Ishfaq-code/magneto/exports/servo-reset/electronics-preview.png

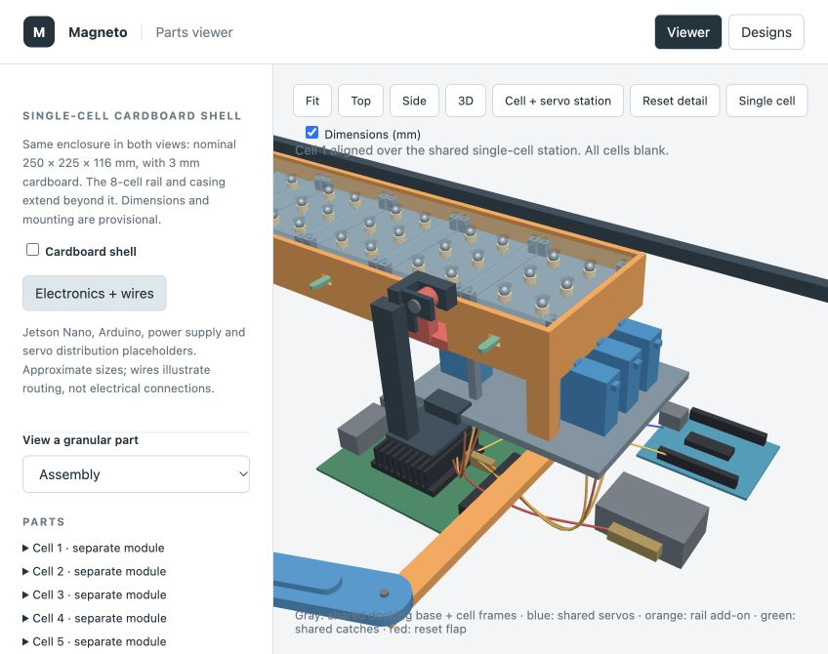
exports/servo-reset/electronics-preview.png
