Ishfaq-code/magneto/story-fullscreen.png

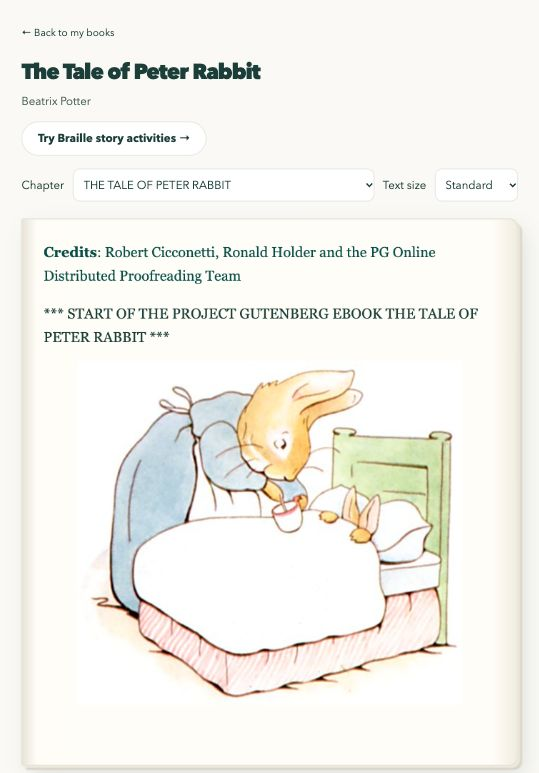
story-fullscreen.png
