Ishfaq-code/magneto/.lavish/databricks-architecture.html

MAGNETO / HACKATHON BUILD MAP

# One mistake changes the next teaching moment.

Proposed architecture: Databricks directs the learning experience. The local runtime preserves the story and controls physical interaction.

## The adaptive loop

MLflow traces every director turn: context, tool requests, output, latency, state version and a concise decision reason.

## Databricks component checklist

Component | Magneto responsibility
Databricks Apps | Host one Python learning-director API. The local device initiates authenticated HTTPS requests.
Foundation Model APIs | One available instruction model with structured-output support chooses when to continue, inspect or teach. Validate its output in code.
Unity Catalog + Delta | Store ordered story passages, teacher-curated opportunities, sourced Braille similarity rules, and durable session analytics. Cache the small reference set for live use.
Lakebase | Store current session position, recent answers and simple per-letter practice state. Commit each answer before the next agent decision.
MLflow Tracing + Evaluation | Show why the director intervened; test story preservation, valid actions, error-driven reinforcement and missing-prop behavior.
Notebook | Load demo data, clearly label synthetic histories and inspect outcomes. No Spark job per dot or learner response.

Lean fallback: if Lakebase is unavailable, keep session state in the local Python runtime, send the latest state on every request, and persist event batches to Delta. Databricks still makes the teaching decisions.

## Monday → Tuesday → Wednesday

Apple / A: known letter → continue. Pear / P: weak letter → inspect pear → show P → record incorrect answer. Plum / P: updated state contains the pear error → choose another short P activity.

Wait for the Tuesday answer before finalizing Wednesday’s intervention. Prefetch narration, but recompute the teaching decision using the latest event.

The model chooses a letter; a deterministic local Braille lookup maps it to dots and calibrated servo positions. The original passage text is immutable; generated teaching audio plays between passages.

## Keep the MVP focused

Skip vector search for a single short story, multi-agent orchestration, model fine-tuning and extensive dashboards. Confirm the YOLO model actually recognizes pear and plum; otherwise use a tested custom model or explicit teacher confirmation.

On invalid output or network timeout, continue the approved narration without a new hardware action. Keep credentials in the local backend and use event IDs to prevent duplicate scoring.

Proposed design, not a deployed system. Styling follows Magneto’s existing slate, blue and white viewer theme.

Official documentation: Agents and Apps (https://docs.databricks.com/aws/en/agents/tutorials/agent-quickstart) · Structured model outputs (https://docs.databricks.com/aws/en/machine-learning/foundation-model-apis/api-reference) · Lakebase state (https://docs.databricks.com/aws/en/oltp/projects/state-management) · MLflow tracing (https://docs.databricks.com/aws/en/mlflow3/genai/tracing/)
