Ishfaq-code/magneto/.lavish/databricks-research-preview.png

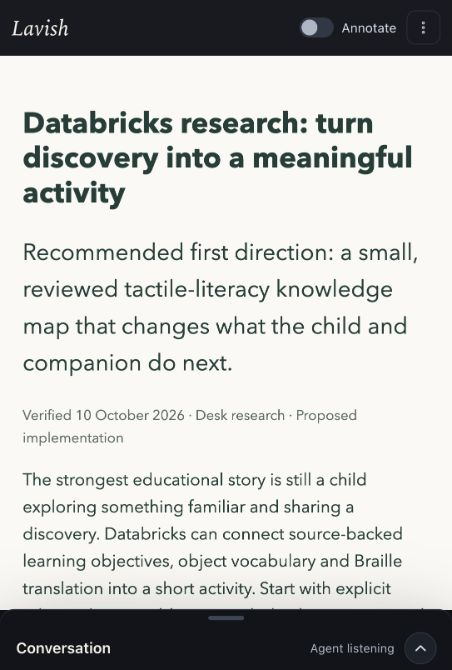
.lavish/databricks-research-preview.png
