Ishfaq-code/magneto/docs/companion-preview.png

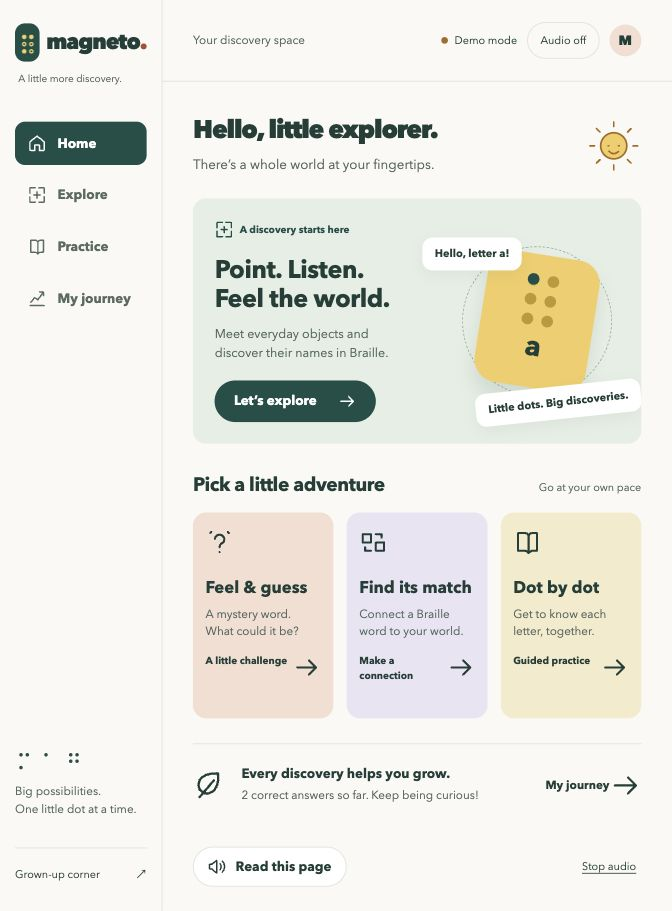
docs/companion-preview.png
