Ishfaq-code/magneto/docs/companion-responsive.png

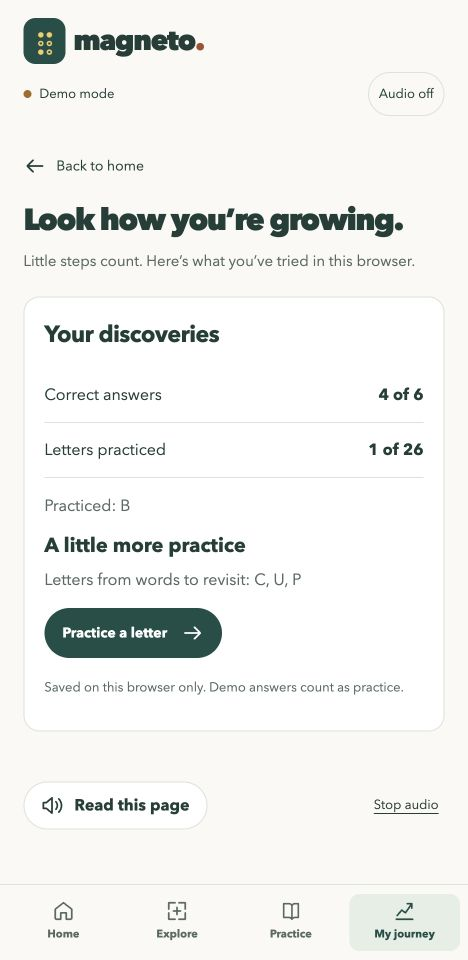
docs/companion-responsive.png
