Ishfaq-code/magneto/exports/cart-arms-single-bed-preview.png

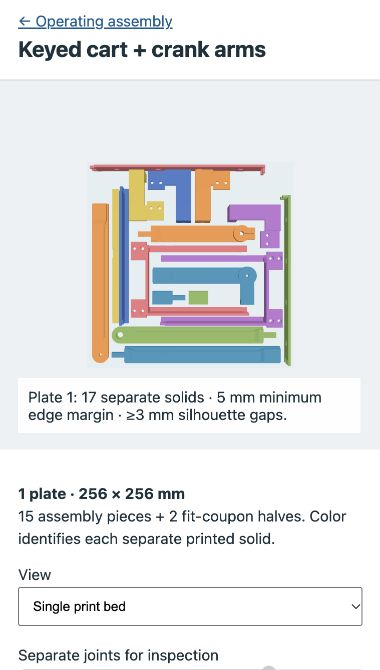
exports/cart-arms-single-bed-preview.png
