Ishfaq-code/magneto/exports/centauri-carbon-bed-layout.png

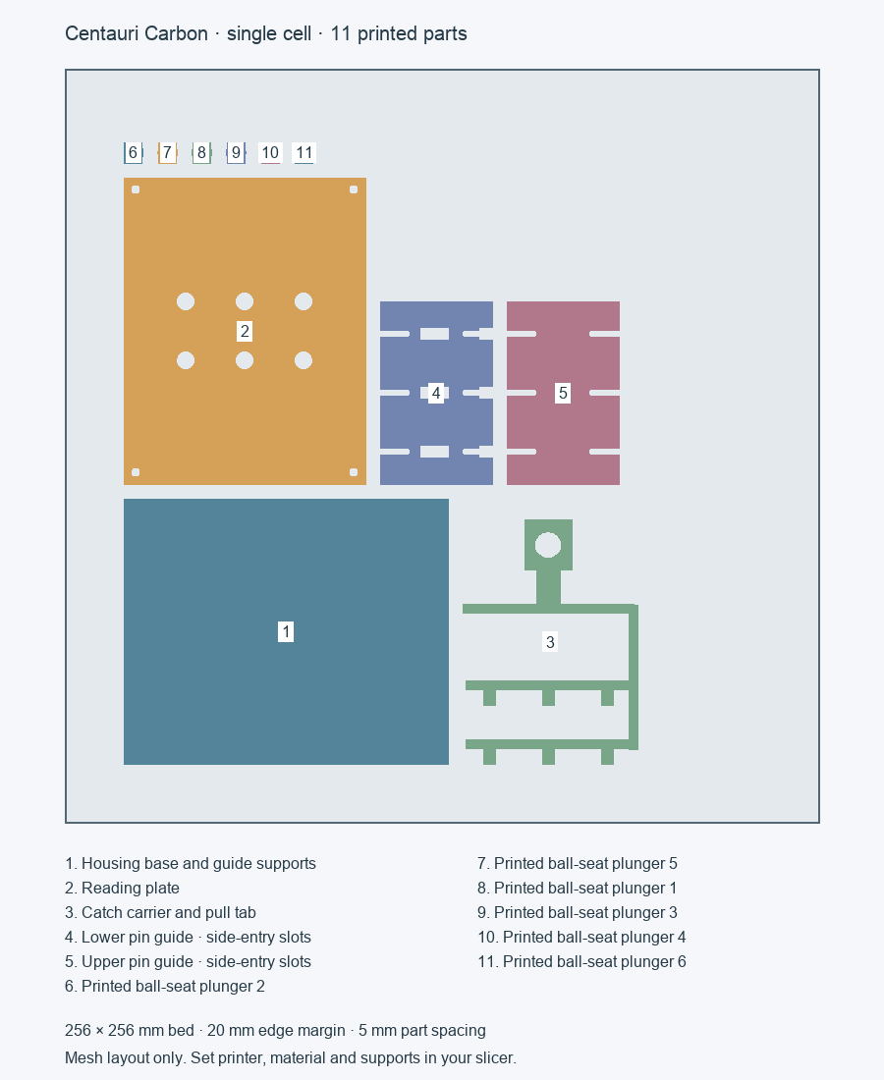
exports/centauri-carbon-bed-layout.png
