Ishfaq-code/magneto/exports/eight-cell/carrier-preview.jpg

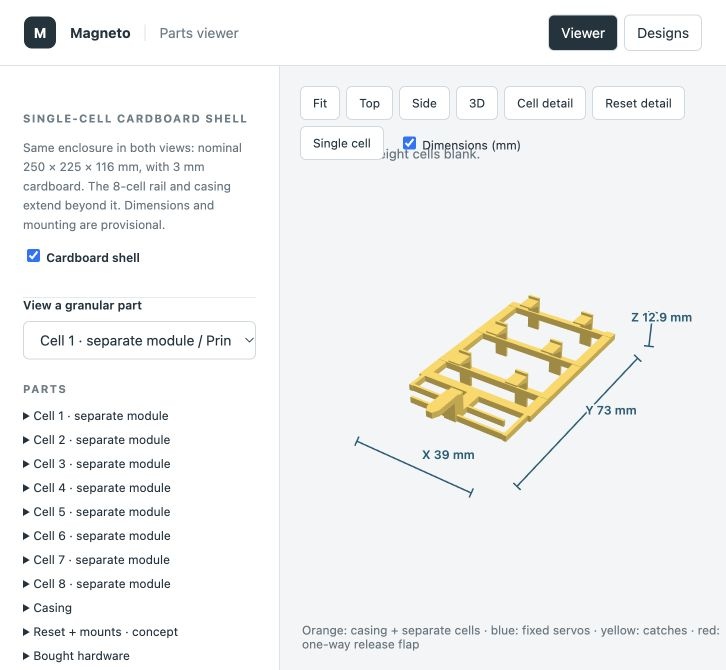
exports/eight-cell/carrier-preview.jpg
