Ishfaq-code/magneto/exports/eight-cell/compact-casing-preview.jpg

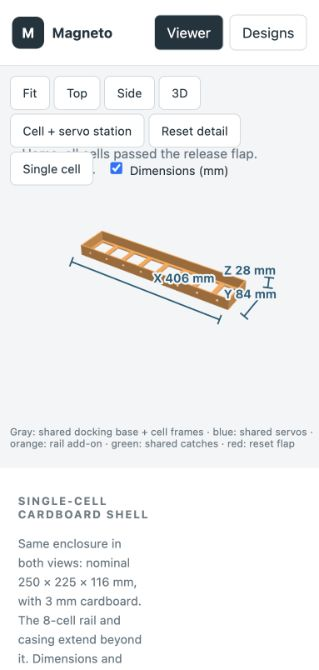
exports/eight-cell/compact-casing-preview.jpg
