Ishfaq-code/magneto/exports/eight-cell/compact-towing-eye-preview.jpg

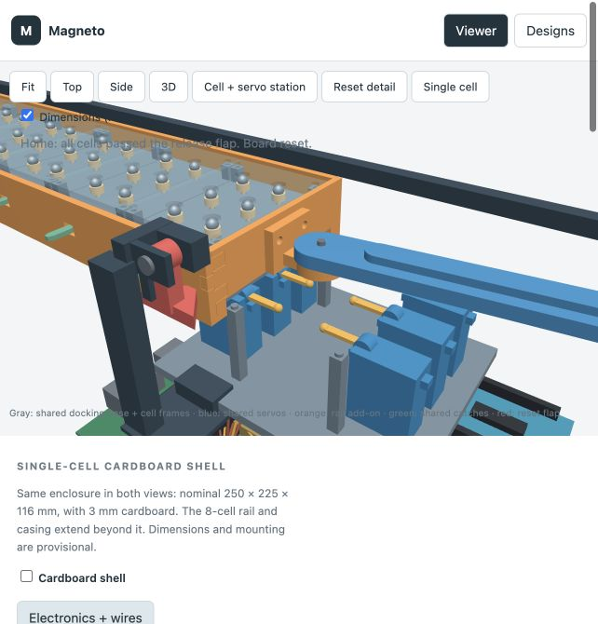
exports/eight-cell/compact-towing-eye-preview.jpg
