Ishfaq-code/magneto/exports/eight-cell/drive-bearing-joint-preview.jpg

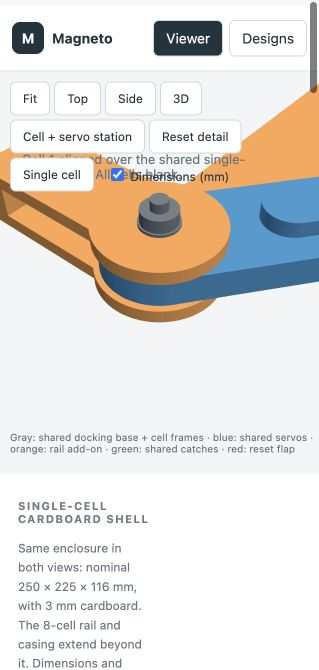
exports/eight-cell/drive-bearing-joint-preview.jpg
