Ishfaq-code/magneto/exports/eight-cell/finger-joint-preview.png

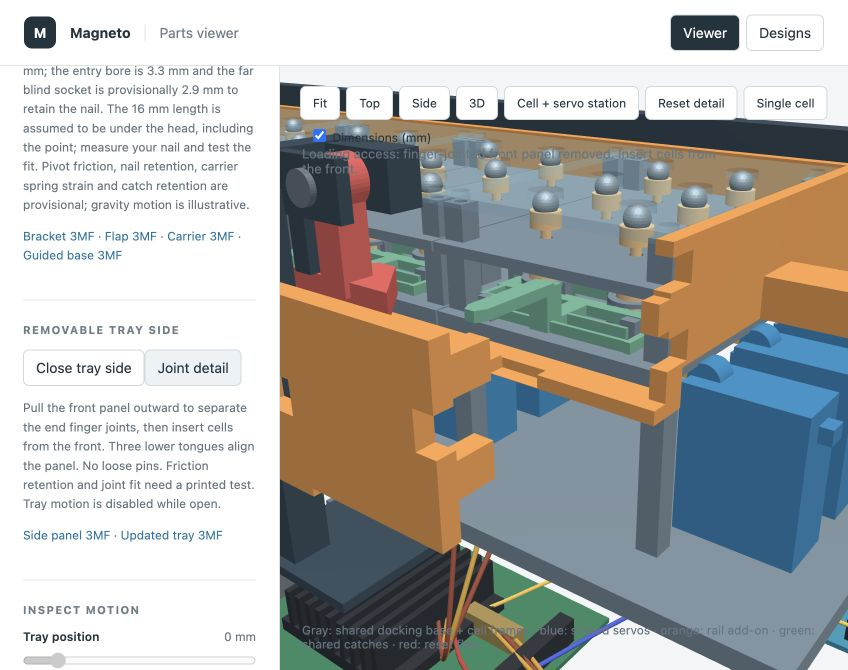
exports/eight-cell/finger-joint-preview.png
