Ishfaq-code/magneto/exports/eight-cell/front-tow-clearance-preview.jpg

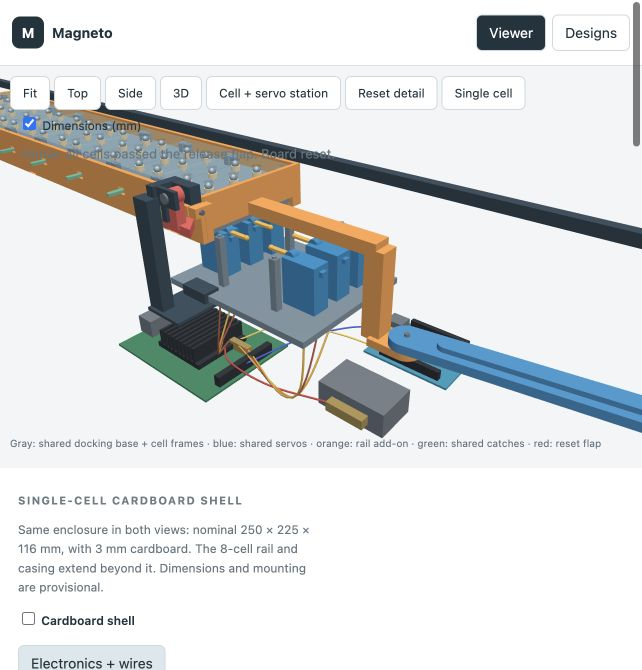
exports/eight-cell/front-tow-clearance-preview.jpg
