Ishfaq-code/magneto/exports/eight-cell/gravity-reset-preview.jpg

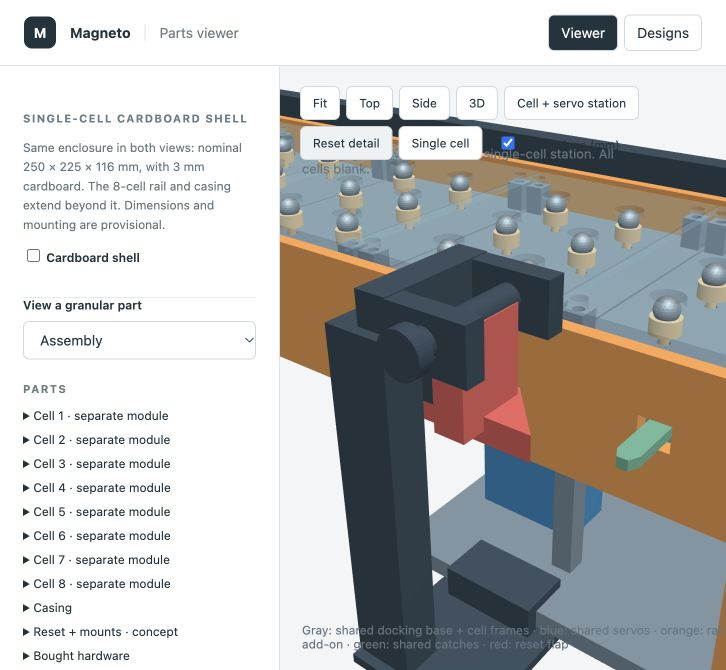
exports/eight-cell/gravity-reset-preview.jpg
