Ishfaq-code/magneto/exports/eight-cell/nail-reset-preview.jpg

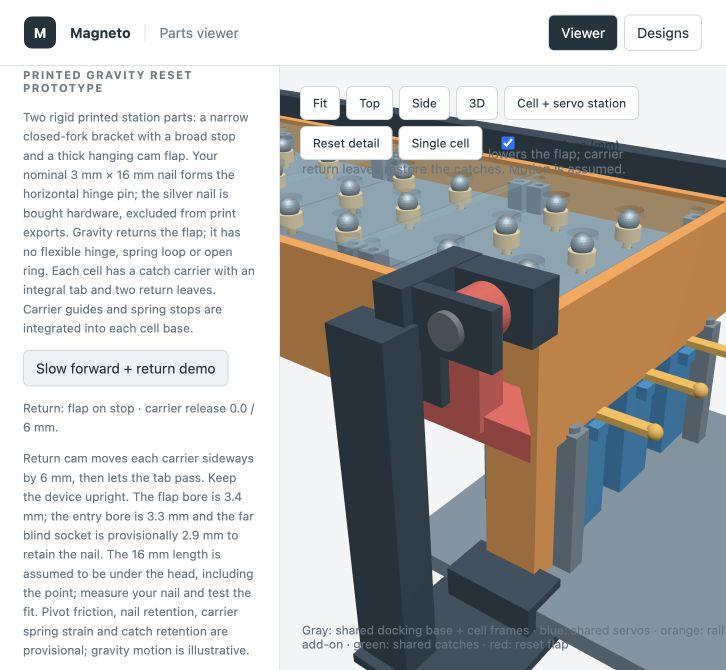
exports/eight-cell/nail-reset-preview.jpg
