Ishfaq-code/magneto/exports/eight-cell/removable-panel-preview.png

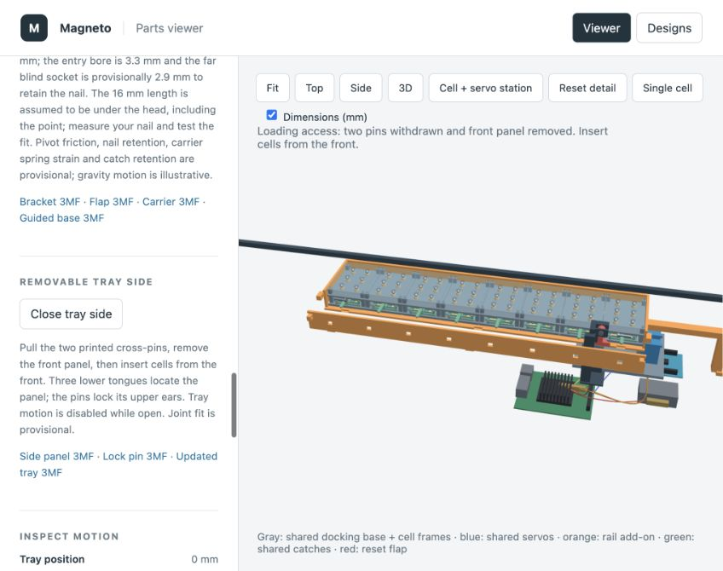
exports/eight-cell/removable-panel-preview.png
