Ishfaq-code/magneto/exports/eight-cell/reset-preview.jpg

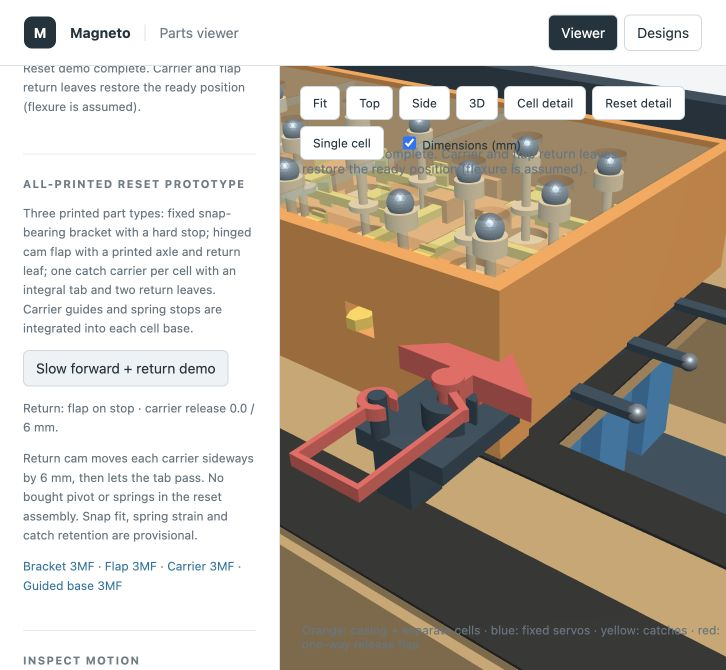
exports/eight-cell/reset-preview.jpg
