Ishfaq-code/magneto/exports/eight-cell/under-tray-rails-preview.jpg

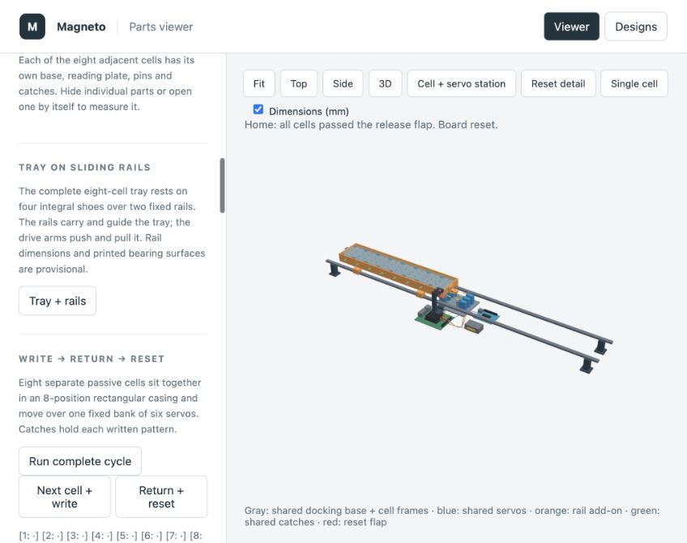
exports/eight-cell/under-tray-rails-preview.jpg
