Ishfaq-code/magneto/exports/eight-cell/wheeled-cart-preview.jpg

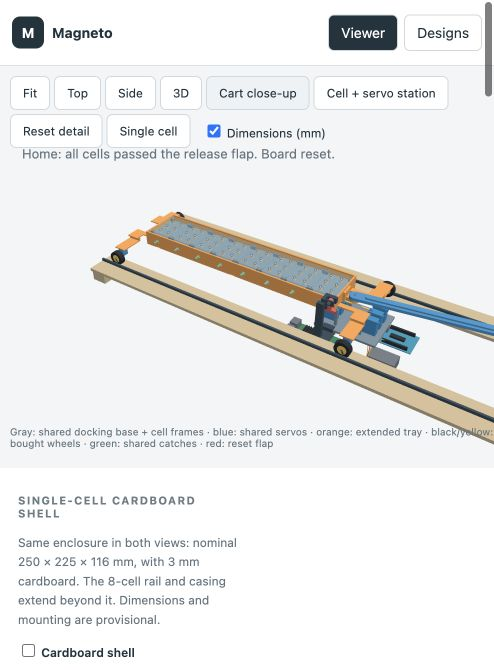
exports/eight-cell/wheeled-cart-preview.jpg
