Ishfaq-code/magneto/exports/plunger-keeper-preview.png

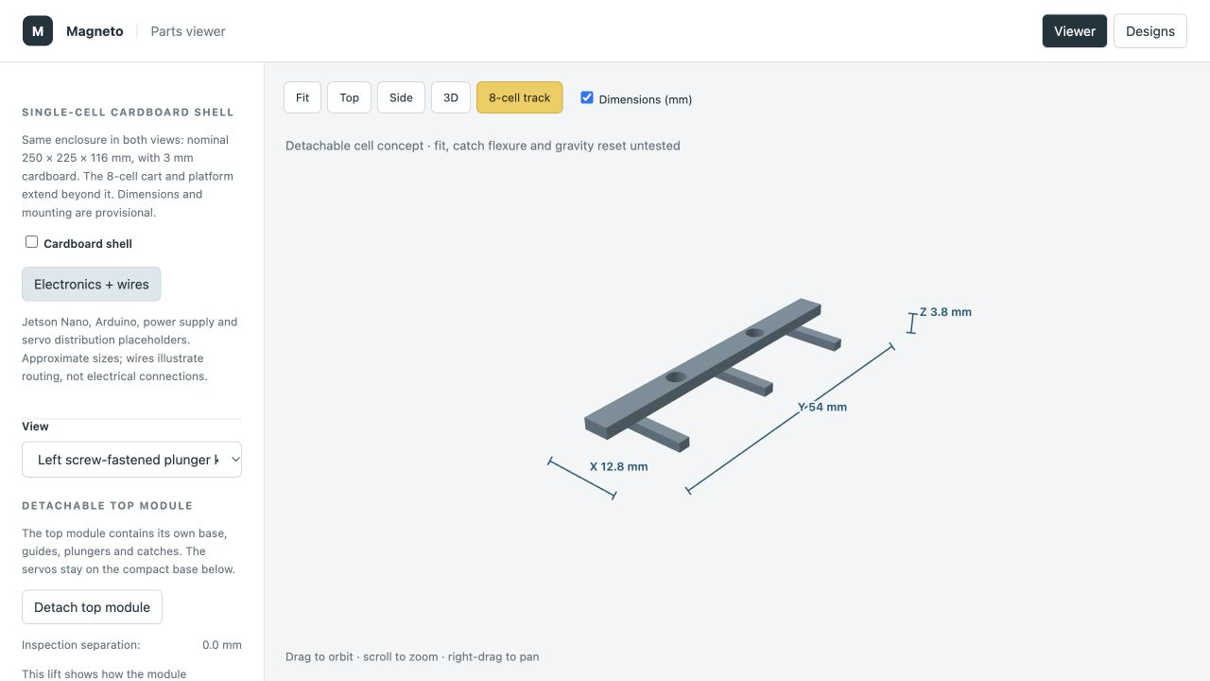
exports/plunger-keeper-preview.png
