Ishfaq-code/magneto/exports/removable-axle-holder-preview.png

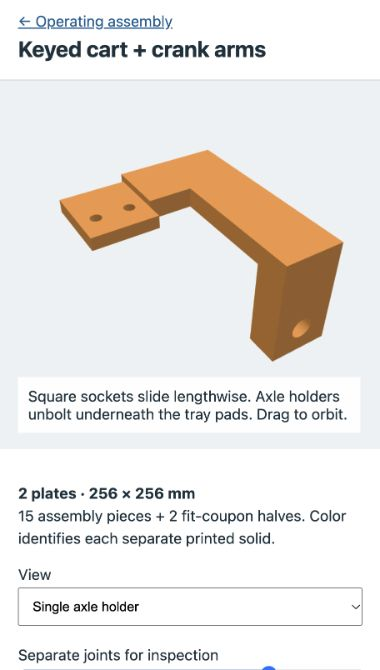
exports/removable-axle-holder-preview.png
