Ishfaq-code/magneto/exports/removable-holders-cart-preview.png

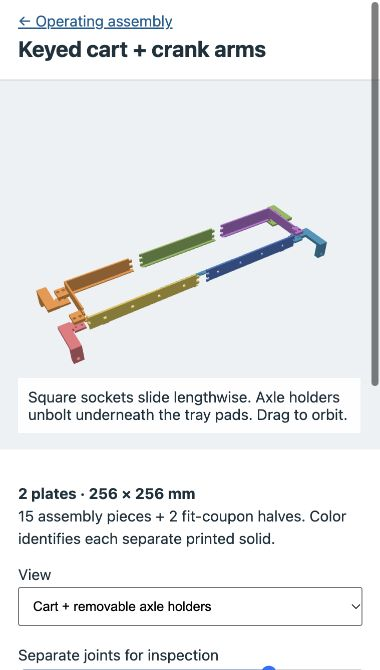
exports/removable-holders-cart-preview.png
