Ishfaq-code/magneto/exports/restored-plunger-slots.png

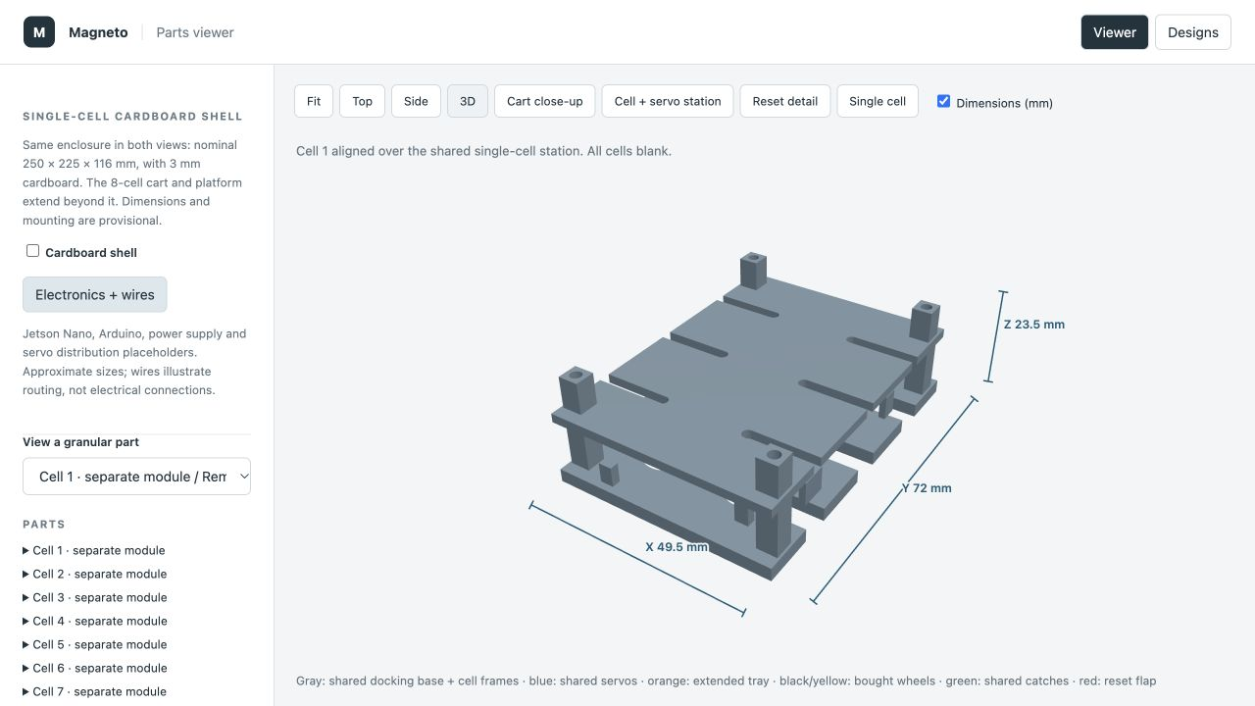
exports/restored-plunger-slots.png
