Ishfaq-code/magneto/exports/servo-reset/detachable-cell-preview.jpg

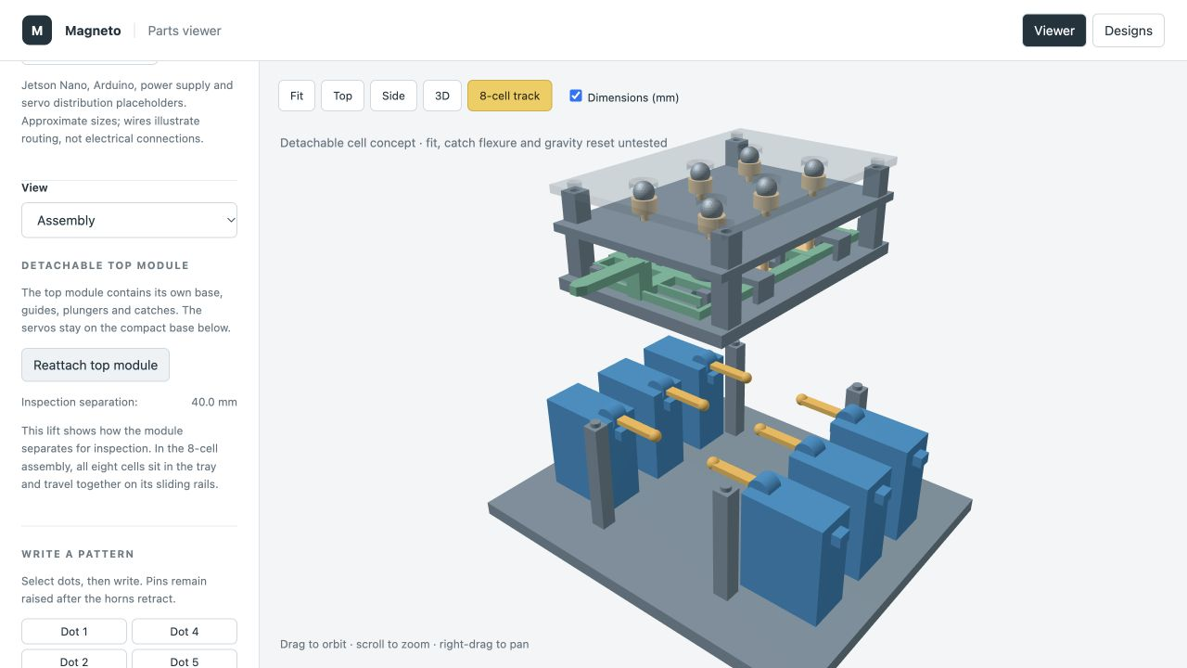
exports/servo-reset/detachable-cell-preview.jpg
