Ishfaq-code/magneto/exports/servo-reset/eight-cell-shared-plunger-preview.png

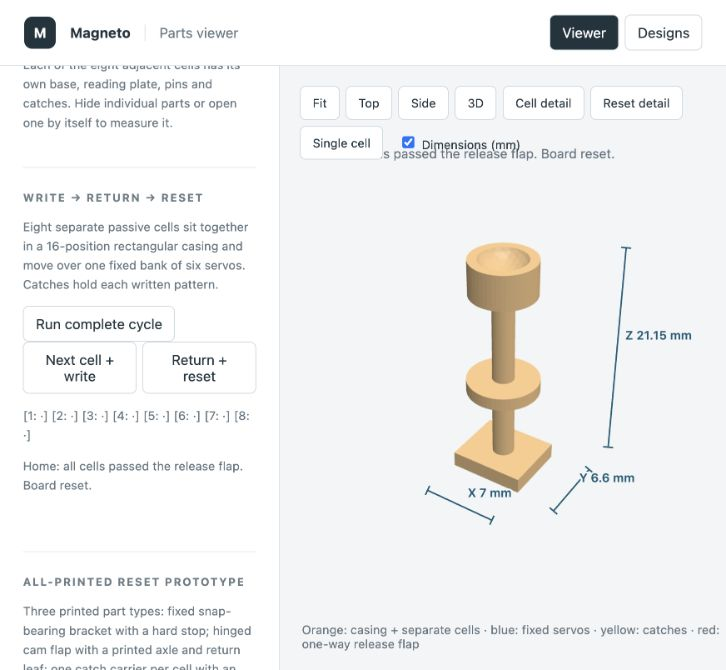
exports/servo-reset/eight-cell-shared-plunger-preview.png
