Ishfaq-code/magneto/exports/servo-reset/gravity-seated-preview.png

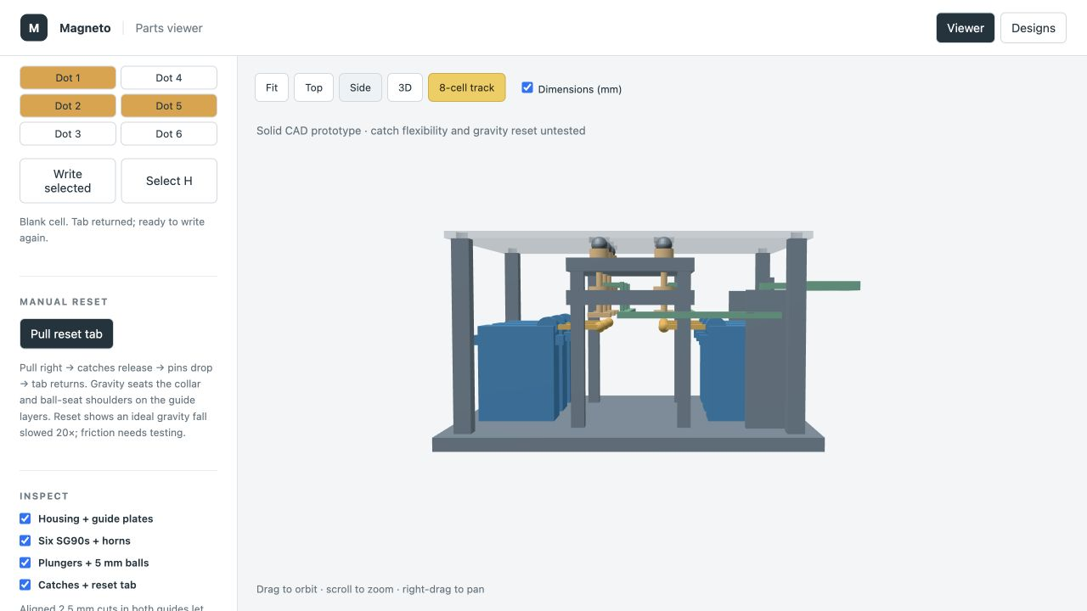
exports/servo-reset/gravity-seated-preview.png
