Ishfaq-code/magneto/exports/servo-reset/plunger-seat-preview.png

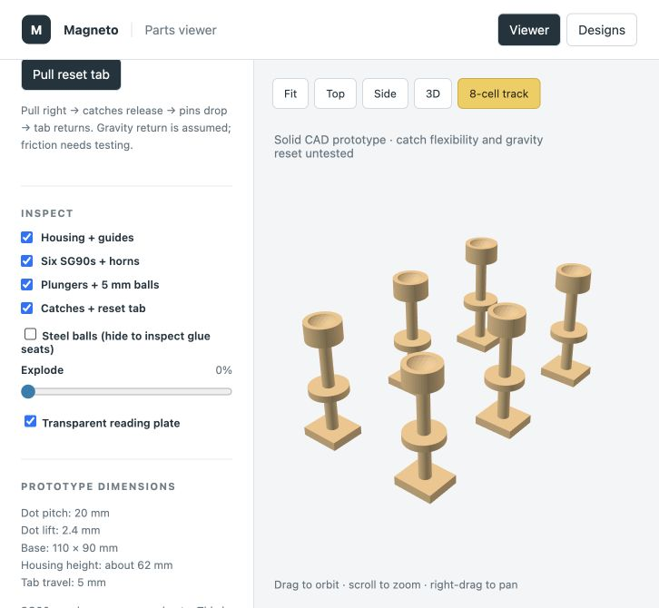
exports/servo-reset/plunger-seat-preview.png
