Ishfaq-code/magneto/exports/servo-reset/shared-station-rail-preview.png

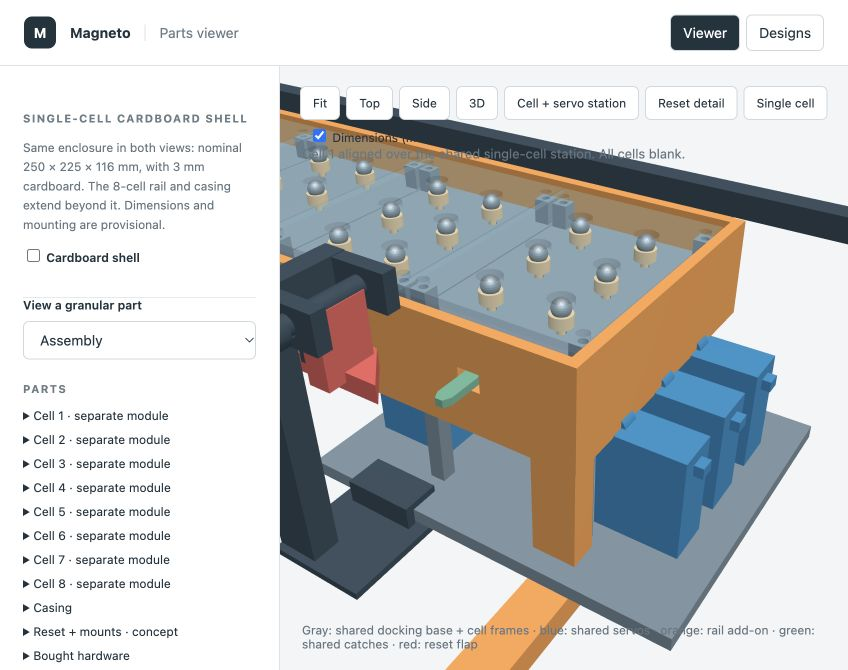
exports/servo-reset/shared-station-rail-preview.png
