Ishfaq-code/magneto/exports/servo-reset/sliding-cell-preview.jpg

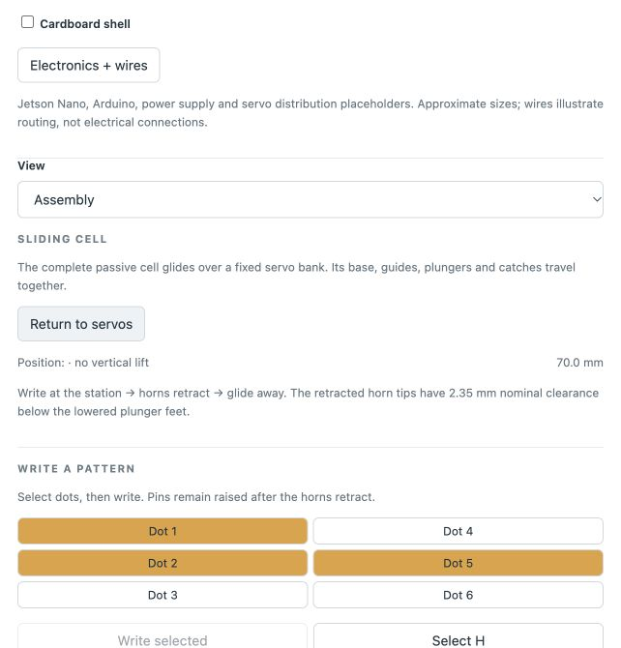
exports/servo-reset/sliding-cell-preview.jpg
