Ishfaq-code/magneto/exports/servo-reset/standalone-shared-cell-preview.png

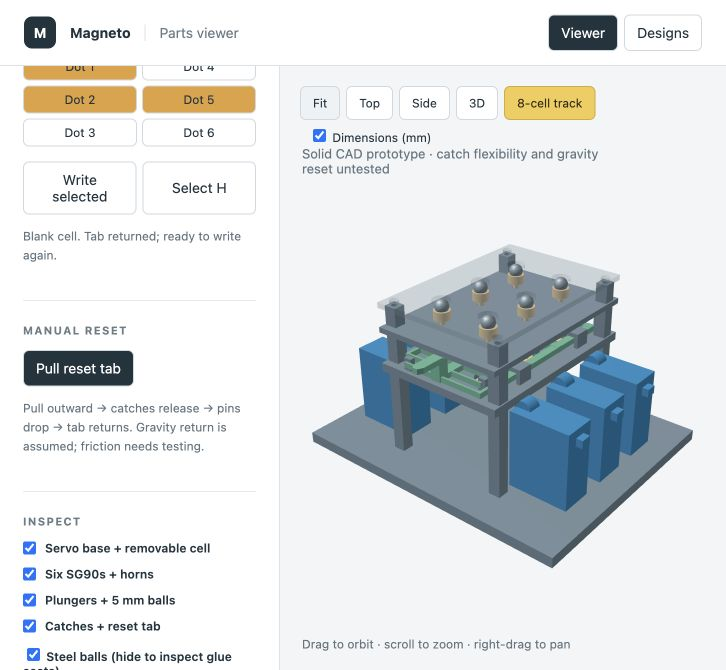
exports/servo-reset/standalone-shared-cell-preview.png
