Ishfaq-code/magneto/exports/split-cart-arms-preview.png

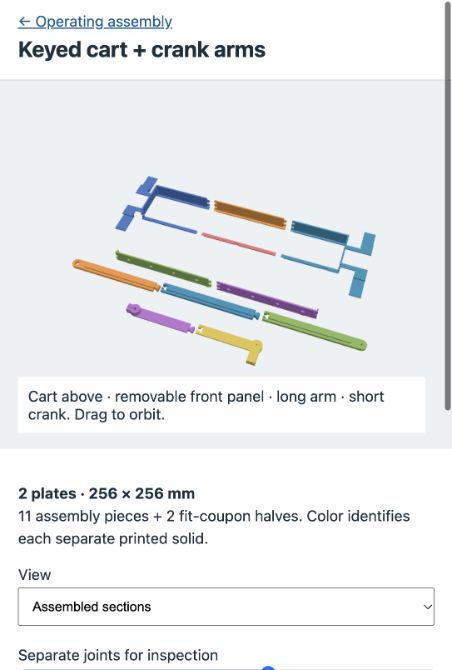
exports/split-cart-arms-preview.png
