Ishfaq-code/magneto/exports/square-socket-preview.png

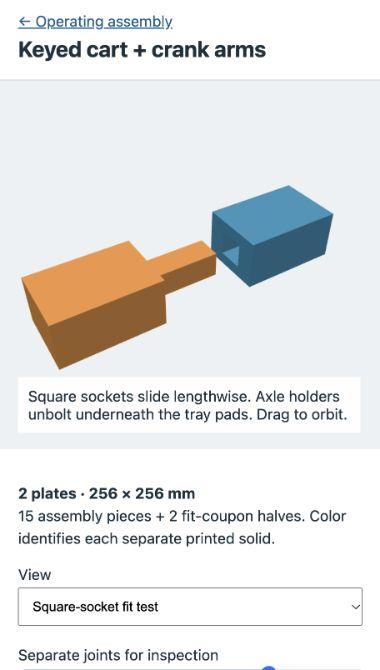
exports/square-socket-preview.png
