Ishfaq-code/magneto/home-restored.png

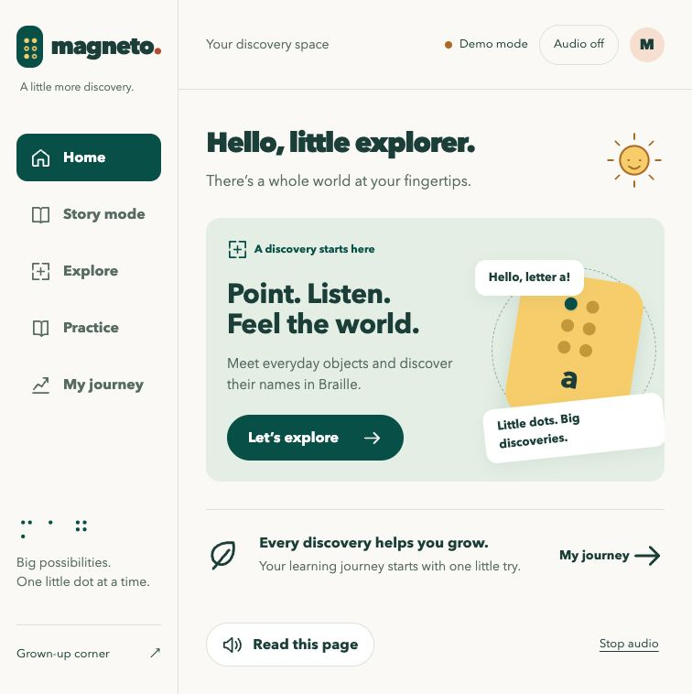
home-restored.png
