Ishfaq-code/magneto/peter-rabbit-activities.png

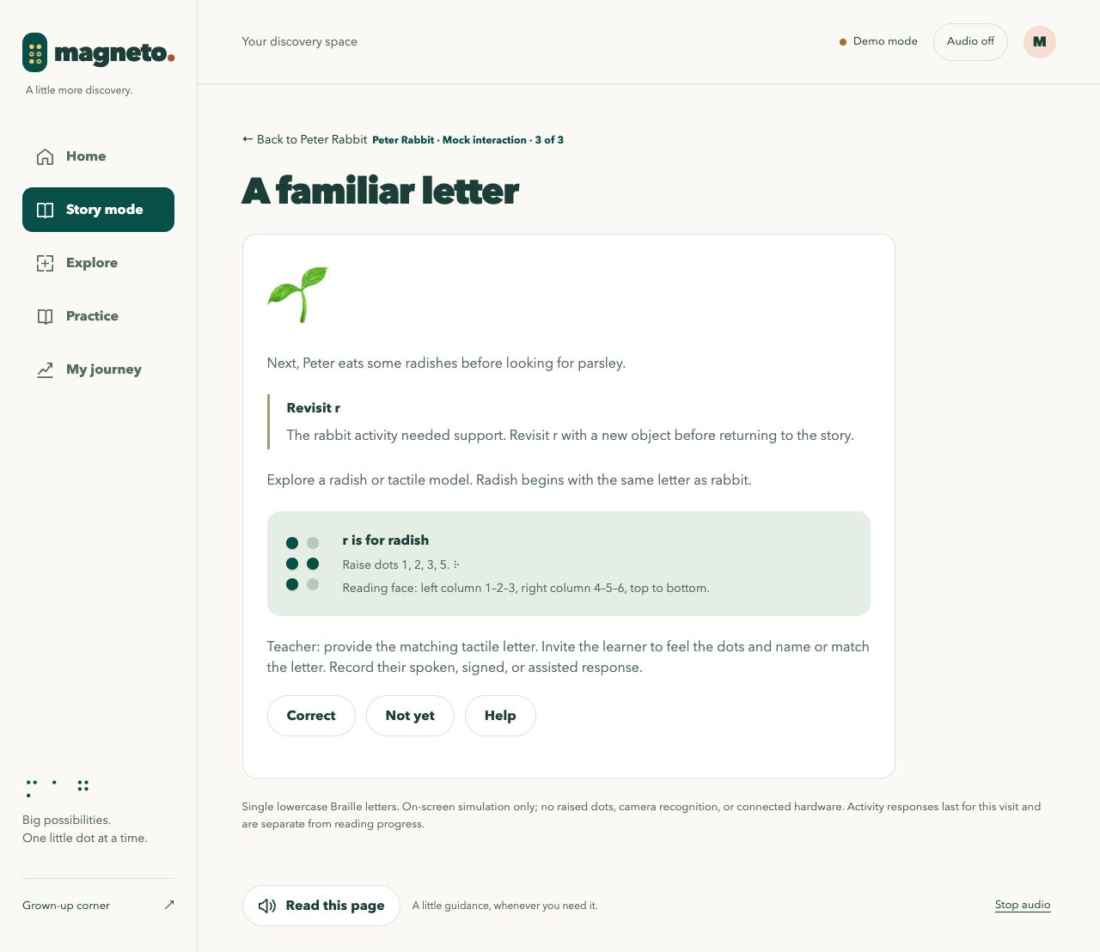
peter-rabbit-activities.png
