Ishfaq-code/magneto/reports/live-plum-continue.png

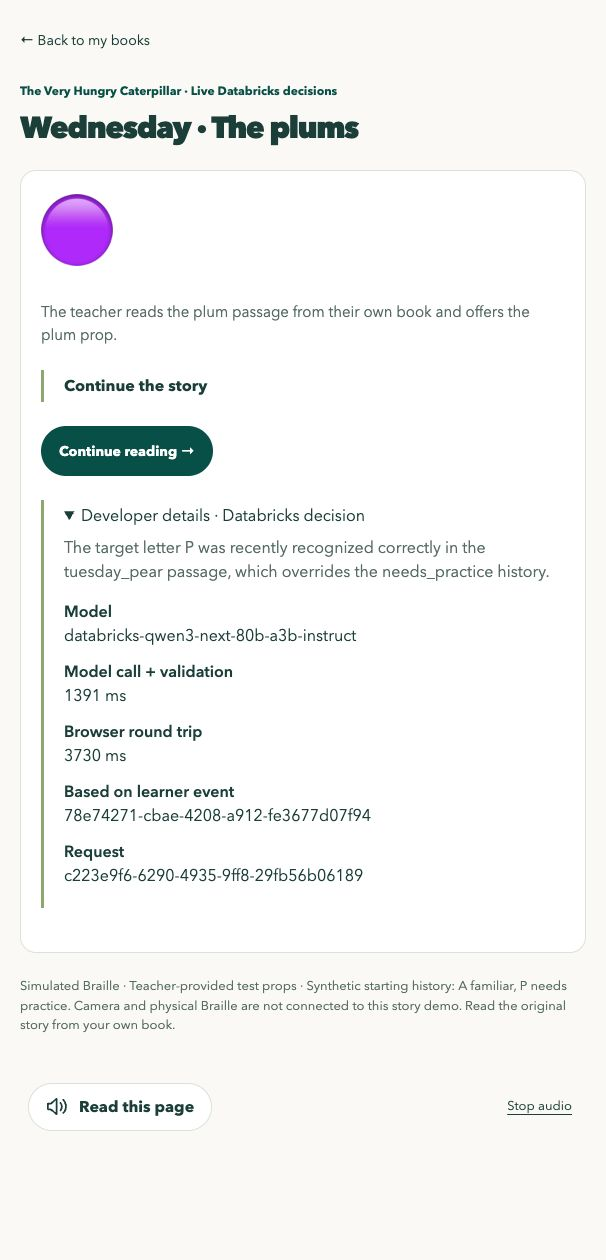
reports/live-plum-continue.png
