Ishfaq-code/magneto/reports/live-plum-teach.png

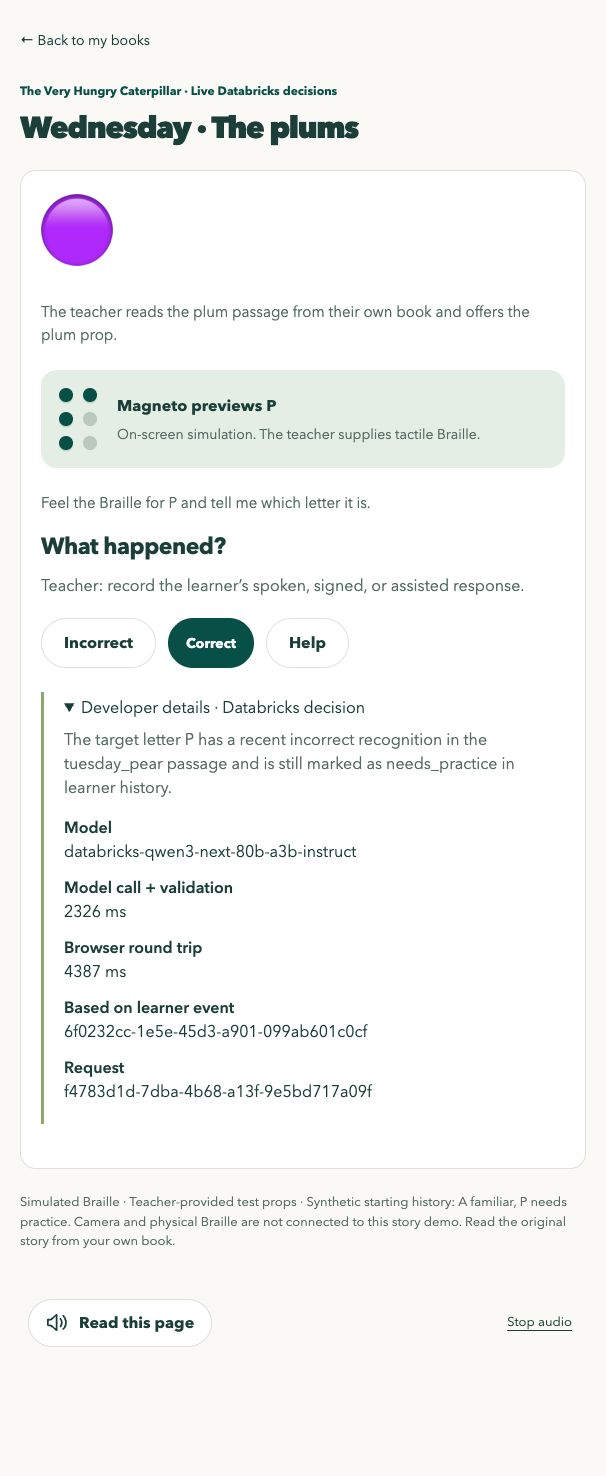
reports/live-plum-teach.png
