Ishfaq-code/magneto/story-mode-coach.png

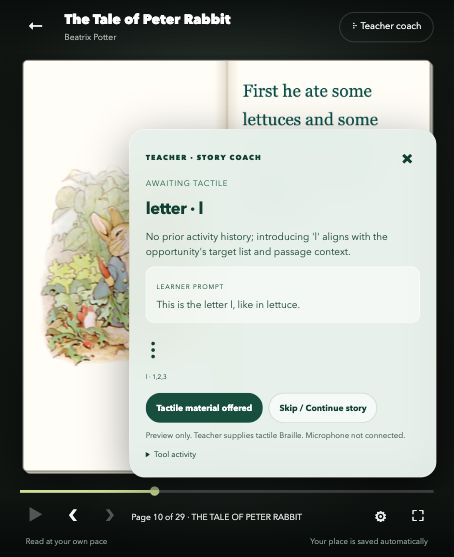
story-mode-coach.png
