Ishfaq-code/magneto/story-player.png

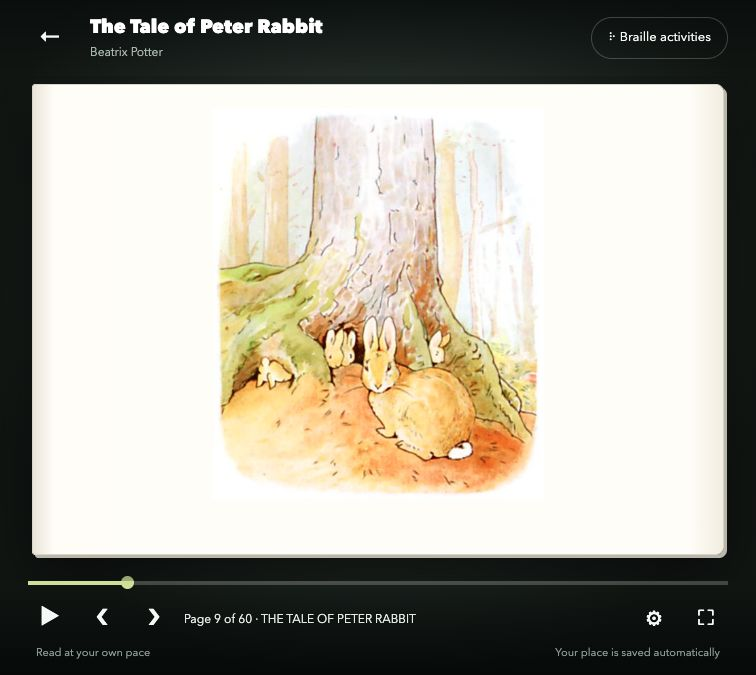
story-player.png
