Ishfaq-code/magneto/story-spread.png

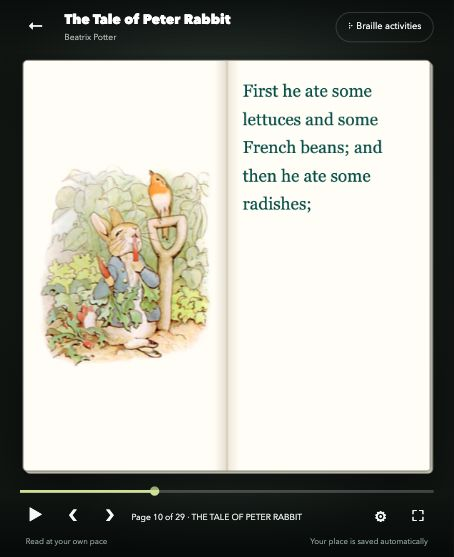
story-spread.png
