Ishfaq-code/magneto/exports/readable/assembly_CONCEPT.3mf

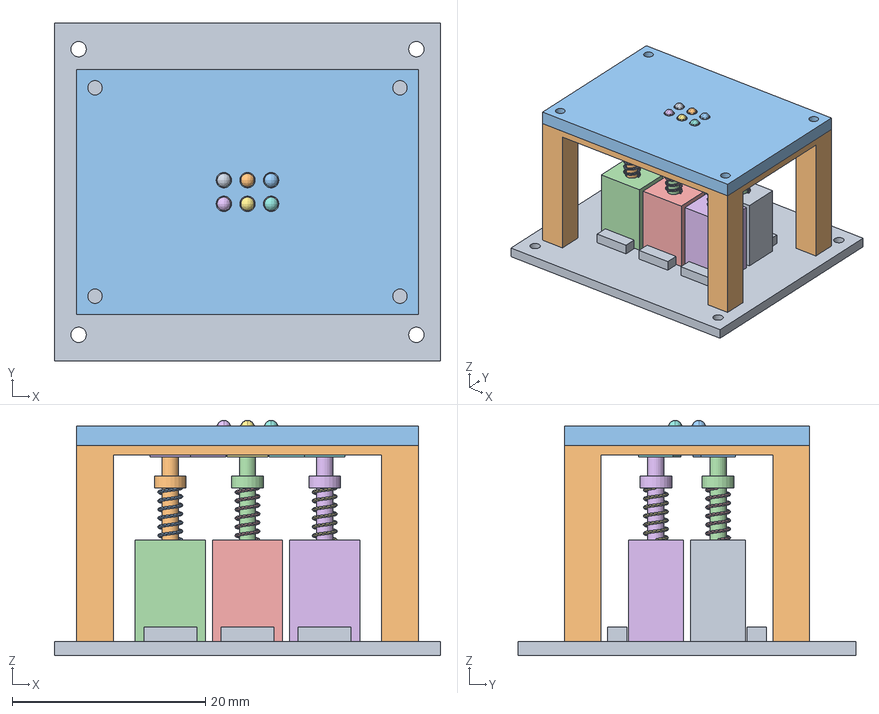
[picture p40: CAD file, 2026-10-10]
exports/readable/assembly_CONCEPT.3mf
40.0 x 35.0 x 24.4 mm
Base and actuator seating
Case support frame
Reading lid
Solenoid 1
Solenoid 2
Solenoid 3
Solenoid 4
Solenoid 5
Solenoid 6
Plunger 1
Return spring 1
Plunger 2
Return spring 2
Plunger 3
Return spring 3
Plunger 4
Return spring 4
Plunger 5
Return spring 5
Plunger 6
Return spring 6
Offset adapter and dot 1
Offset adapter and dot 2
Offset adapter and dot 3
Offset adapter and dot 4
Offset adapter and dot 5
Offset adapter and dot 6
