Ishfaq-code/magneto/exports/servo-reset/assembly_CONCEPT.3mf

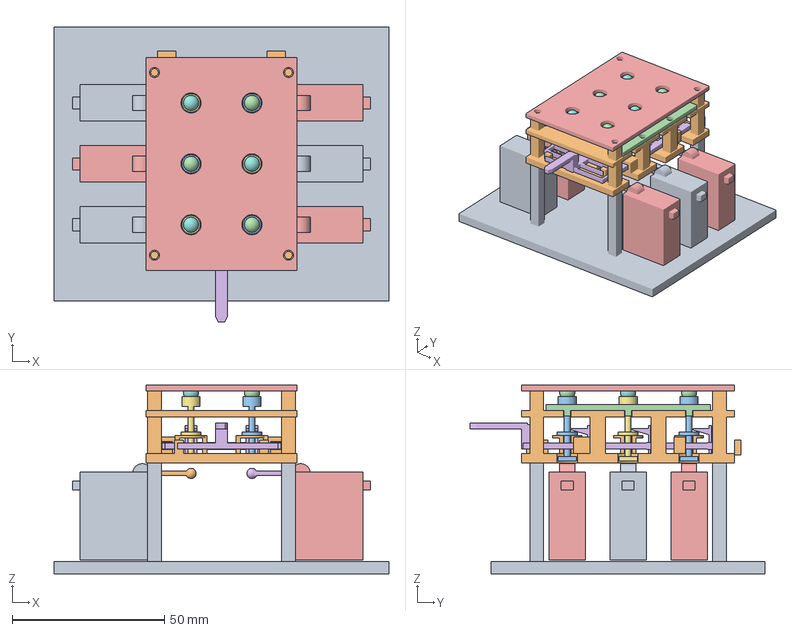
[picture p41: CAD file, 2026-10-10]
exports/servo-reset/assembly_CONCEPT.3mf
110.0 x 97.0 x 62.0 mm
Standalone servo base with cell docking posts
Removable cell base with supports and stem guide
Left screw-fastened plunger keeper
Right screw-fastened plunger keeper
Removable cell reading plate
Shared transverse catch carrier and reset tab
Printed ball-seat plunger 1
Bought 5 mm steel ball 1
SG90 envelope 1
Servo horn 1
Printed ball-seat plunger 2
Bought 5 mm steel ball 2
SG90 envelope 2
Servo horn 2
Printed ball-seat plunger 3
Bought 5 mm steel ball 3
SG90 envelope 3
Servo horn 3
Printed ball-seat plunger 4
Bought 5 mm steel ball 4
SG90 envelope 4
Servo horn 4
Printed ball-seat plunger 5
Bought 5 mm steel ball 5
SG90 envelope 5
Servo horn 5
Printed ball-seat plunger 6
Bought 5 mm steel ball 6
SG90 envelope 6
Servo horn 6
