Ishfaq-code/magneto/exports/drive/02_long_connecting_arm_DRAFT.3mf

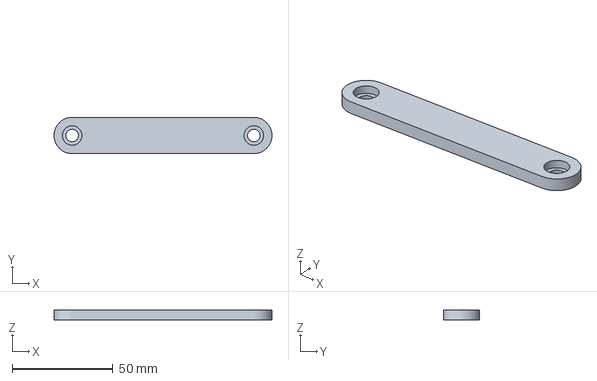
[picture p42: CAD file, 2026-10-10]
exports/drive/02_long_connecting_arm_DRAFT.3mf
108.0 x 18.0 x 5.00 mm
