Ishfaq-code/magneto/exports/eight-cell/drive-short-arm_CONCEPT.3mf

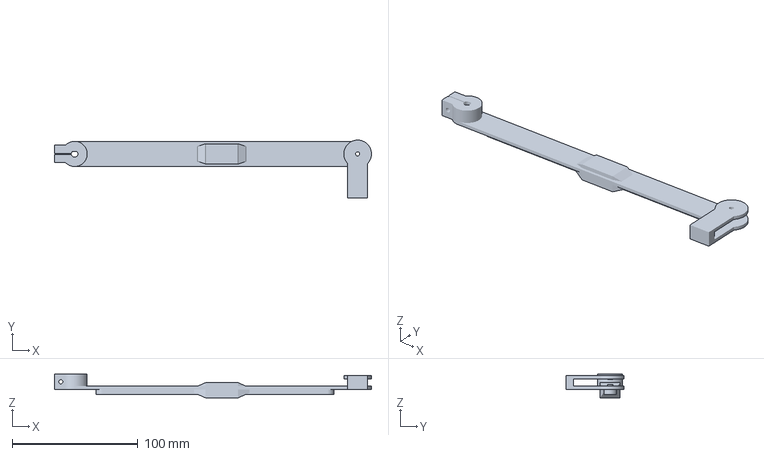
[picture p43: CAD file, 2026-10-10]
exports/eight-cell/drive-short-arm_CONCEPT.3mf
252.0 x 46.0 x 18.8 mm
