Ishfaq-code/magneto/exports/resin-stl/bed-A-quantity-plan/reset-bracket_CONCEPT_qty-01.stl

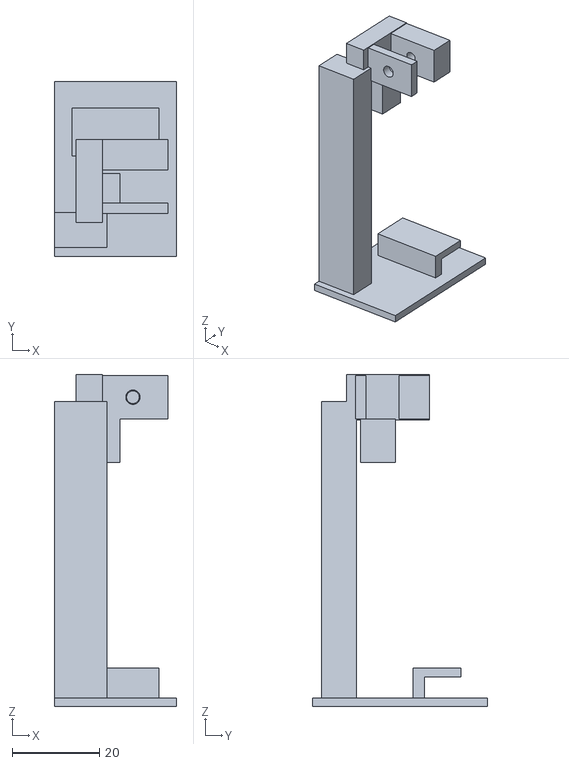
[picture p44: CAD file, 2026-10-10]
exports/resin-stl/bed-A-quantity-plan/reset-bracket_CONCEPT_qty-01.stl
28.0 x 40.0 x 76.1
