Ishfaq-code/magneto/exports/resin-stl/bed-B-quantity-plan/reading-plate_CONCEPT_qty-04.stl

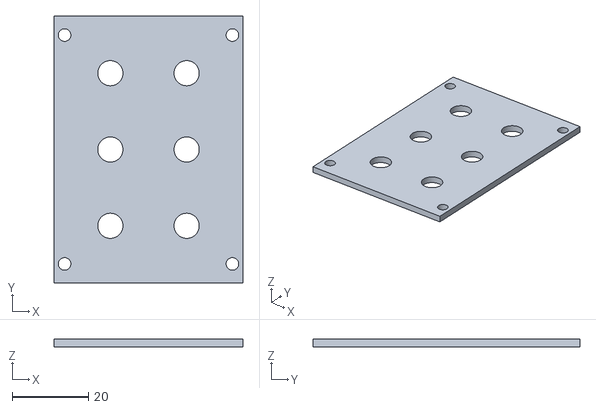
[picture p45: CAD file, 2026-10-10]
exports/resin-stl/bed-B-quantity-plan/reading-plate_CONCEPT_qty-04.stl
49.5 x 70.0 x 2.00
