Ishfaq-code/magneto/exports/resin-stl/optional-extras/ball-seat-plunger_CONCEPT_qty-12.stl

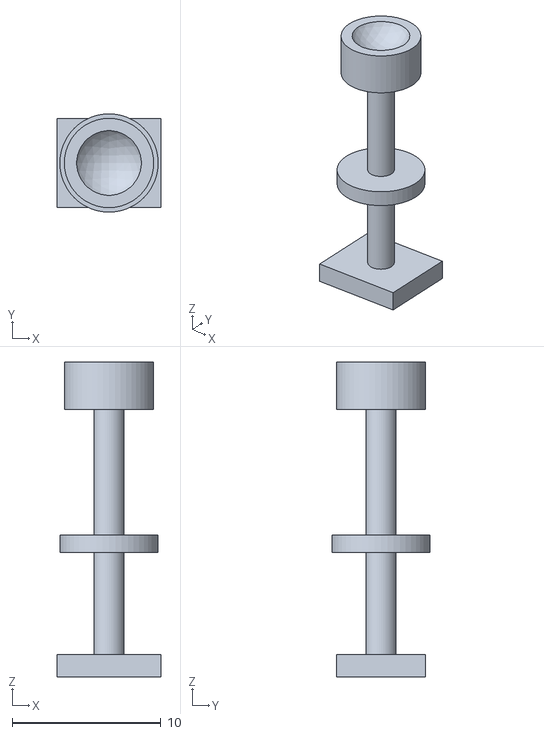
[picture p46: CAD file, 2026-10-10]
exports/resin-stl/optional-extras/ball-seat-plunger_CONCEPT_qty-12.stl
7.00 x 6.60 x 21.2
