Ishfaq-code/magneto/exports/split-cart-arms/arm-fit-coupon-1_CONCEPT.3mf

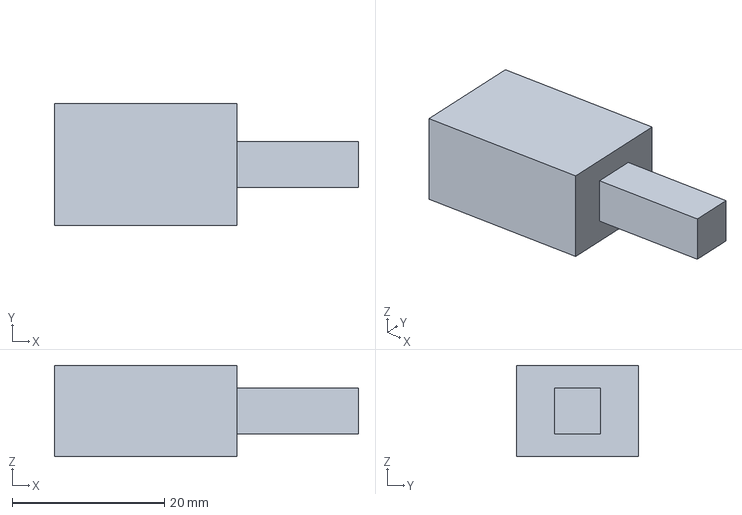
[picture p47: CAD file, 2026-10-10]
exports/split-cart-arms/arm-fit-coupon-1_CONCEPT.3mf
40.0 x 16.0 x 12.0 mm
