Ishfaq-code/magneto/exports/top-module-bed-256x256.3mf

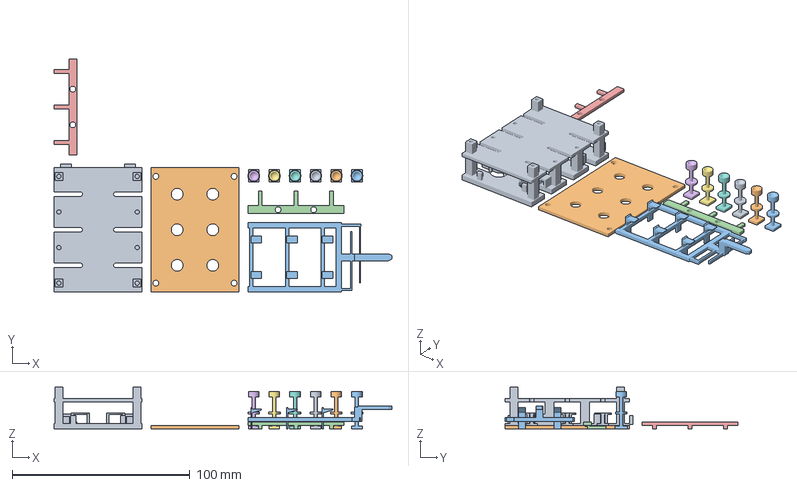
[picture p48: CAD file, 2026-10-10]
exports/top-module-bed-256x256.3mf
190.0 x 131.0 x 23.5 mm
Removable cell base with supports and stem guide
Removable cell reading plate
Shared transverse catch carrier and reset tab
Left screw-fastened plunger keeper
Right screw-fastened plunger keeper
Printed ball-seat plunger 2
Printed ball-seat plunger 5
Printed ball-seat plunger 1
Printed ball-seat plunger 3
Printed ball-seat plunger 4
Printed ball-seat plunger 6
