Ishfaq-code/magneto/exports/drive/01_flat_carriage_bottom_DRAFT.3mf

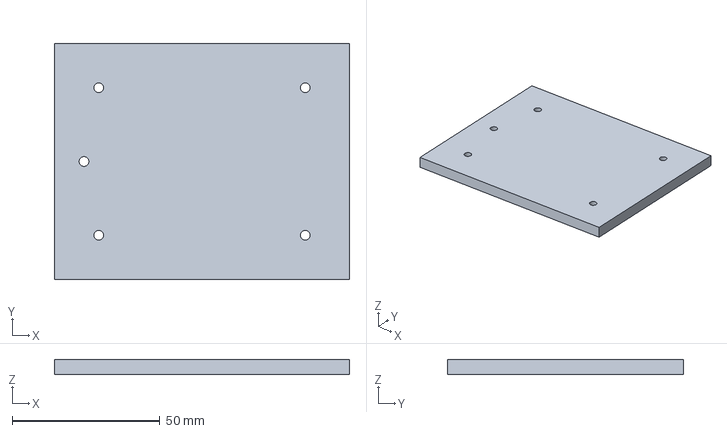
[picture p49: CAD file, 2026-10-10]
exports/drive/01_flat_carriage_bottom_DRAFT.3mf
100.0 x 80.0 x 5.00 mm
