Ishfaq-code/magneto/exports/eight-cell/cell-base_CONCEPT.3mf

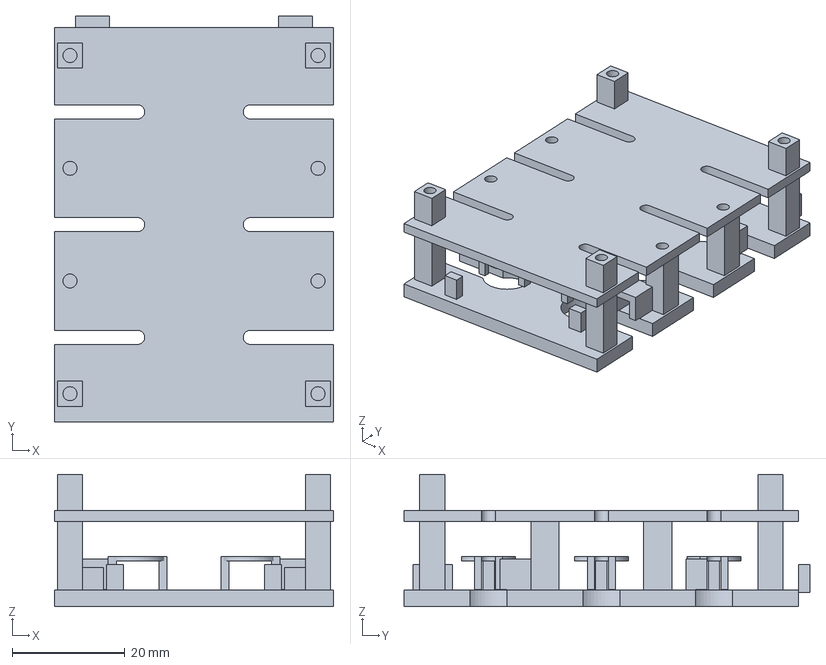
[picture p50: CAD file, 2026-10-10]
exports/eight-cell/cell-base_CONCEPT.3mf
49.5 x 72.0 x 23.5 mm
