Ishfaq-code/magneto/exports/resin-stl/bed-B-quantity-plan/catch-carrier_CONCEPT_qty-04.stl

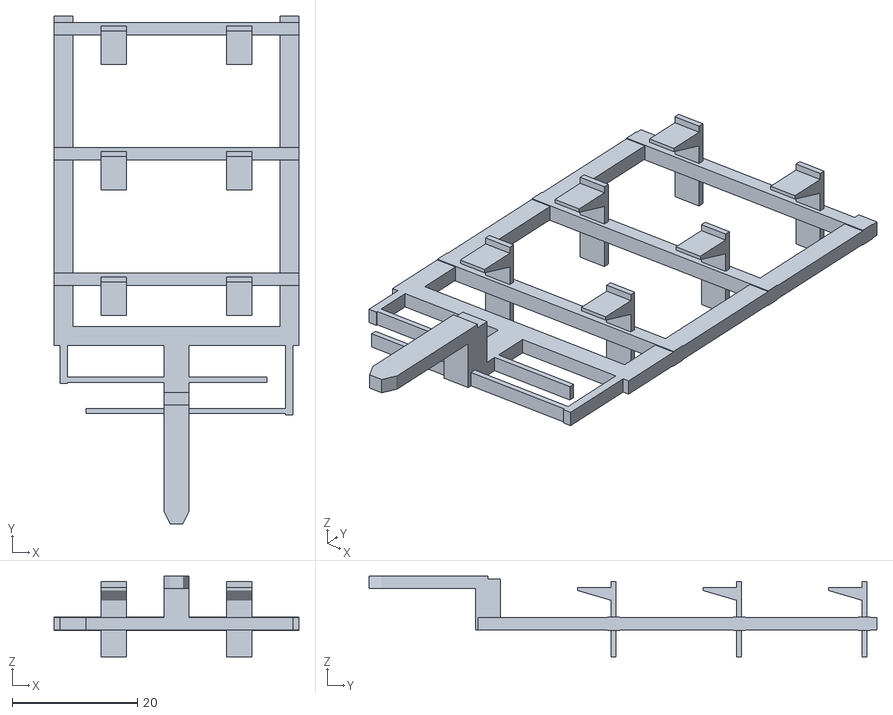
[picture p51: CAD file, 2026-10-10]
exports/resin-stl/bed-B-quantity-plan/catch-carrier_CONCEPT_qty-04.stl
39.0 x 81.0 x 12.9
