Ishfaq-code/magneto/exports/split-cart-arms/arm-fit-coupon-2_CONCEPT.3mf

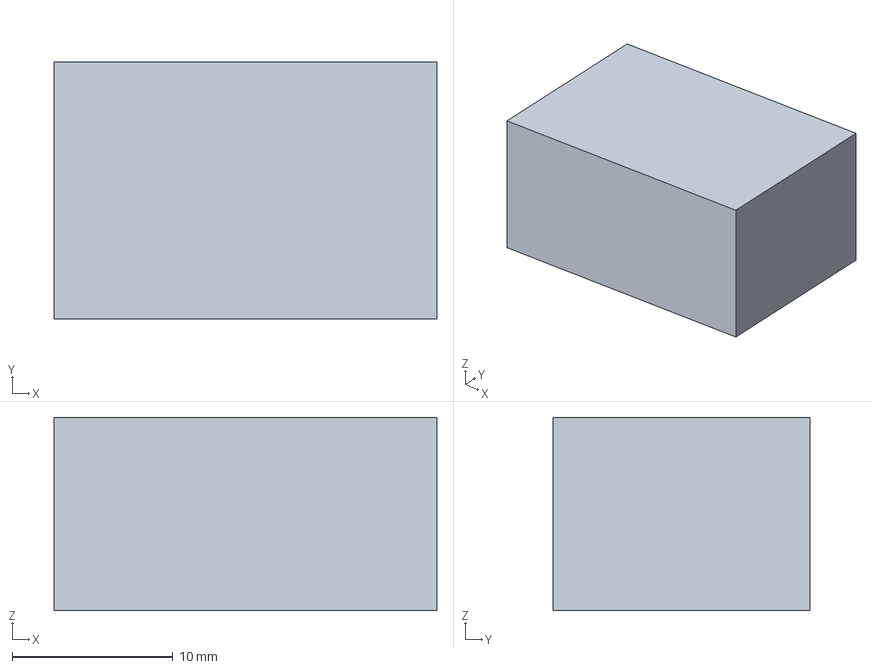
[picture p52: CAD file, 2026-10-10]
exports/split-cart-arms/arm-fit-coupon-2_CONCEPT.3mf
23.8 x 16.0 x 12.0 mm
