Ishfaq-code/magneto/exports/cart-arms-single-bed-256x256_CONCEPT.3mf

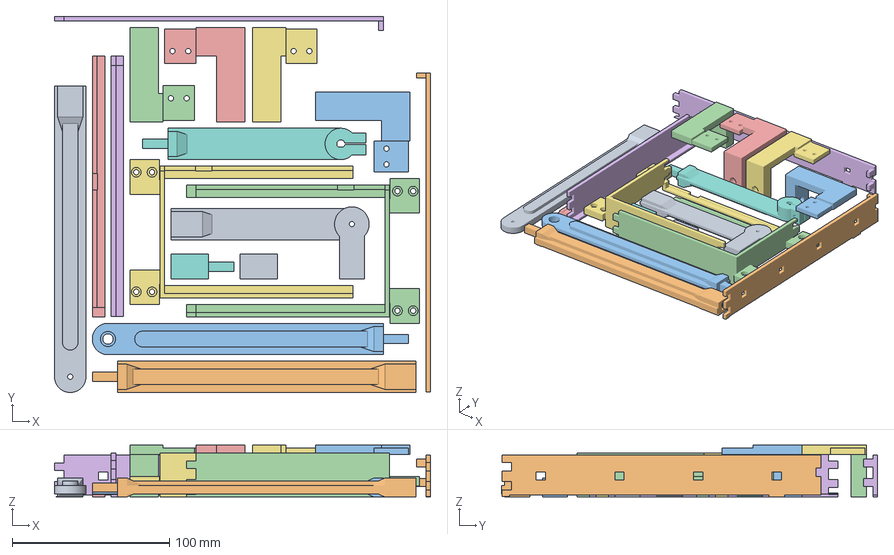
[picture p53: CAD file, 2026-10-10]
exports/cart-arms-single-bed-256x256_CONCEPT.3mf
239.0 x 239.0 x 33.0 mm
drive-long-arm-split-3
drive-long-arm-split-2
drive-long-arm-split-1
casing-split-1
casing-split-2a
casing-split-2b
casing-split-3
drive-short-arm-split-1
drive-short-arm-split-2
casing-panel-split-2
wheel-holder-2-rear
wheel-holder-1-rear
wheel-holder-2-front
casing-panel-split-1
wheel-holder-1-front
arm-fit-coupon-1
arm-fit-coupon-2
