Ishfaq-code/magneto/exports/drive/03_short_crank_arm_DRAFT.3mf

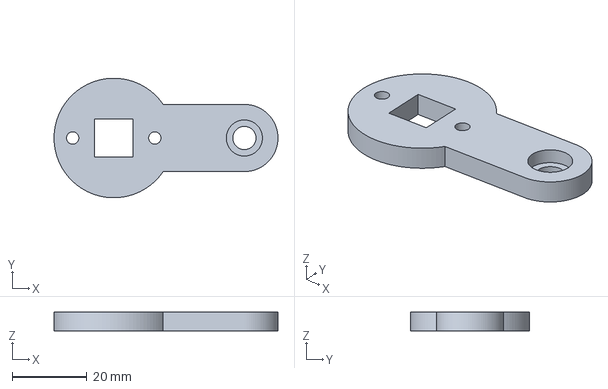
[picture p54: CAD file, 2026-10-10]
exports/drive/03_short_crank_arm_DRAFT.3mf
60.0 x 32.0 x 5.00 mm
