Ishfaq-code/magneto/exports/eight-cell/casing-panel_CONCEPT.3mf

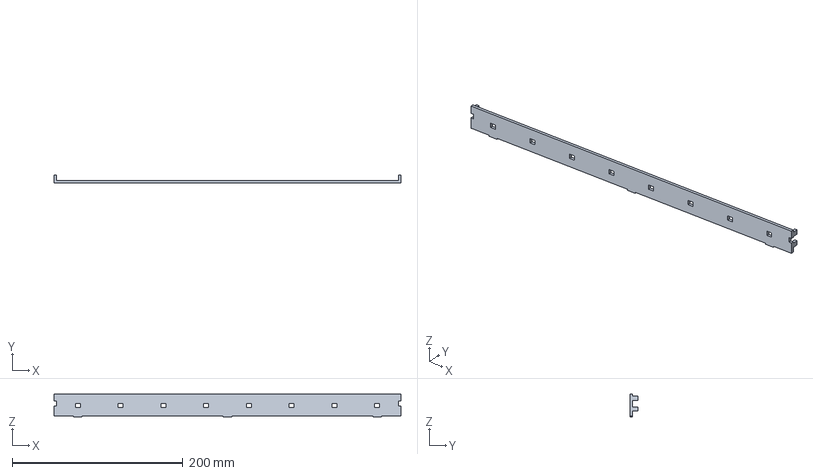
[picture p55: CAD file, 2026-10-10]
exports/eight-cell/casing-panel_CONCEPT.3mf
406.0 x 9.00 x 26.7 mm
