Ishfaq-code/magneto/exports/split-cart-arms/wheel-holder-2-rear_CONCEPT.3mf

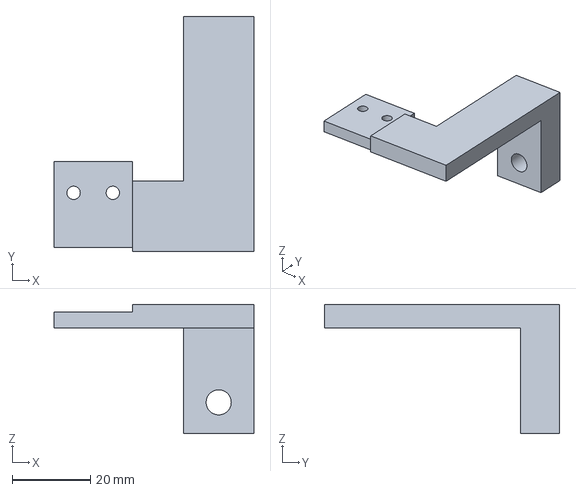
[picture p56: CAD file, 2026-10-10]
exports/split-cart-arms/wheel-holder-2-rear_CONCEPT.3mf
51.0 x 60.0 x 33.0 mm
