Ishfaq-code/magneto/exports/drive/04_motor_shaft_adapter_DRAFT.3mf

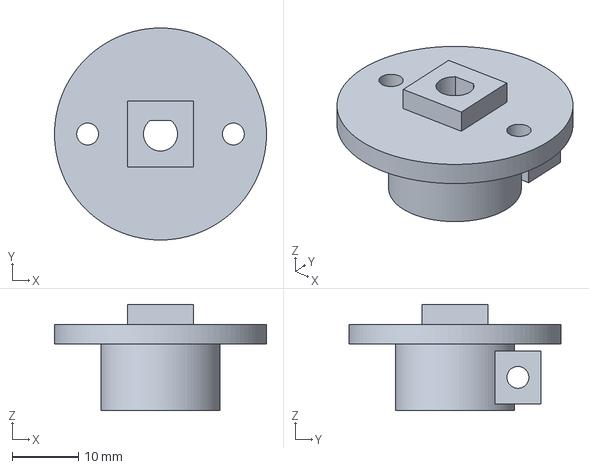
[picture p57: CAD file, 2026-10-10]
exports/drive/04_motor_shaft_adapter_DRAFT.3mf
32.0 x 32.0 x 16.0 mm
