Ishfaq-code/magneto/exports/resin-stl/bed-A-quantity-plan/plunger-keeper-left_CONCEPT_qty-04.stl

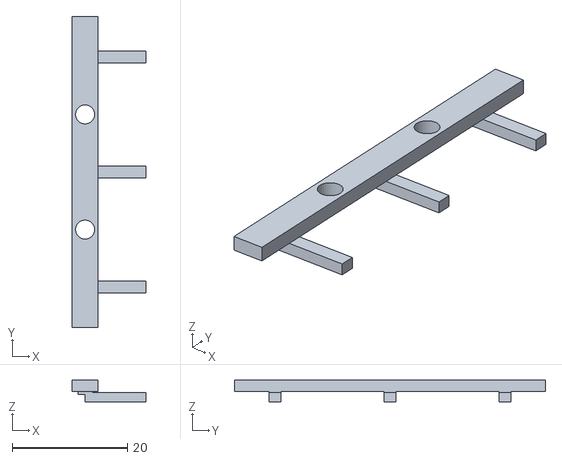
[picture p58: CAD file, 2026-10-10]
exports/resin-stl/bed-A-quantity-plan/plunger-keeper-left_CONCEPT_qty-04.stl
12.8 x 54.0 x 3.80
