Ishfaq-code/magneto/exports/resin-stl/optional-extras/servo-docking-base_CONCEPT_qty-01.stl

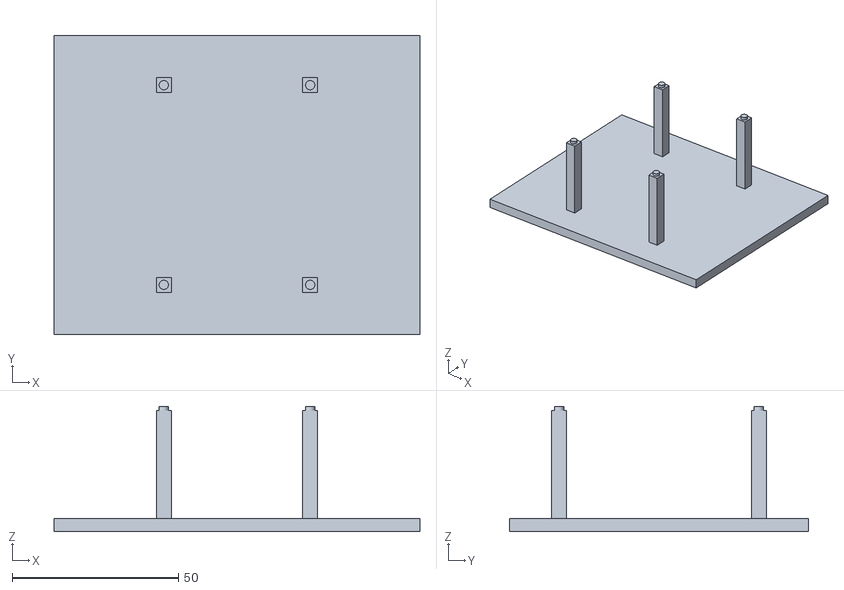
[picture p59: CAD file, 2026-10-10]
exports/resin-stl/optional-extras/servo-docking-base_CONCEPT_qty-01.stl
110.0 x 90.0 x 37.7
