Ishfaq-code/magneto/exports/eight-cell/rail-stand--1--450_CONCEPT.3mf

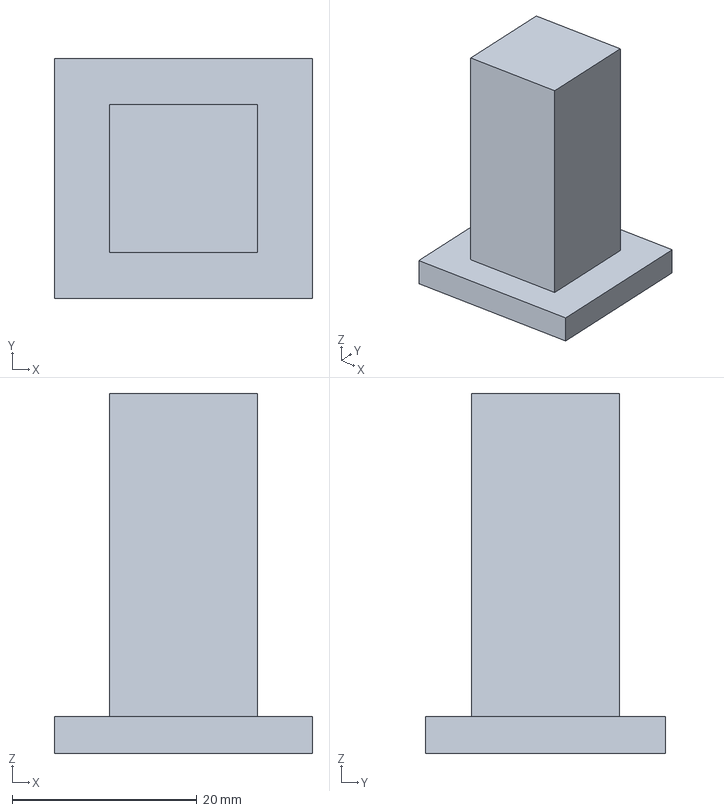
[picture p60: CAD file, 2026-10-10]
exports/eight-cell/rail-stand--1--450_CONCEPT.3mf
28.0 x 26.0 x 39.0 mm
