Ishfaq-code/magneto/exports/split-cart-arms/casing-split-1_CONCEPT.3mf

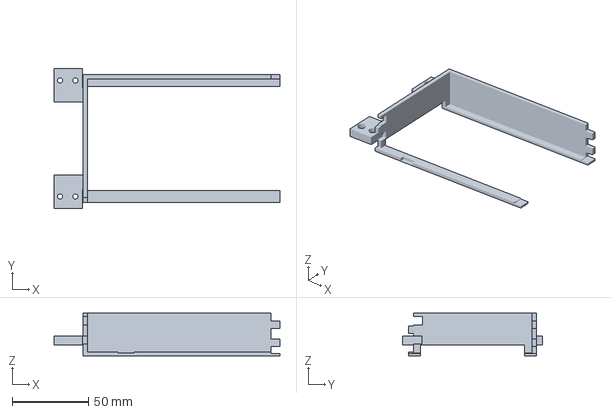
[picture p61: CAD file, 2026-10-10]
exports/split-cart-arms/casing-split-1_CONCEPT.3mf
148.0 x 92.0 x 28.0 mm
