Ishfaq-code/magneto/exports/resin-stl/bed-B-quantity-plan/reset-flap_CONCEPT_qty-01.stl

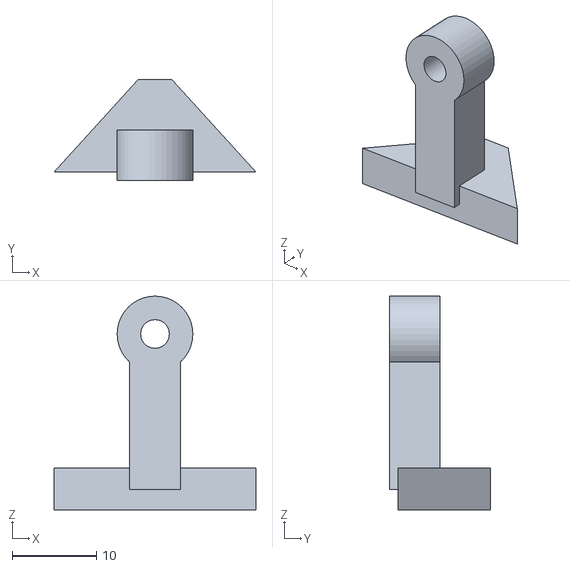
[picture p62: CAD file, 2026-10-10]
exports/resin-stl/bed-B-quantity-plan/reset-flap_CONCEPT_qty-01.stl
24.0 x 12.0 x 25.4
