Ishfaq-code/magneto/exports/single-cell-bed-256x256.3mf

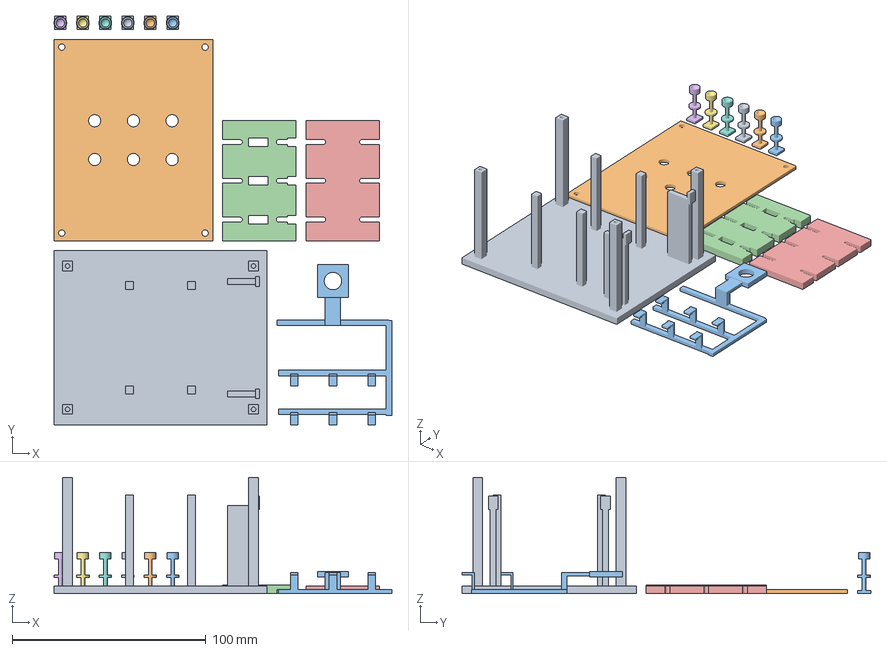
[picture p63: CAD file, 2026-10-10]
exports/single-cell-bed-256x256.3mf
174.5 x 211.0 x 60.0 mm
Housing base and guide supports
Reading plate
Catch carrier and pull tab
Lower pin guide · side-entry slots
Upper pin guide · side-entry slots
Printed ball-seat plunger 2
Printed ball-seat plunger 5
Printed ball-seat plunger 1
Printed ball-seat plunger 3
Printed ball-seat plunger 4
Printed ball-seat plunger 6
