Ishfaq-code/magneto/exports/split-cart-arms/drive-short-arm-split-1_CONCEPT.3mf

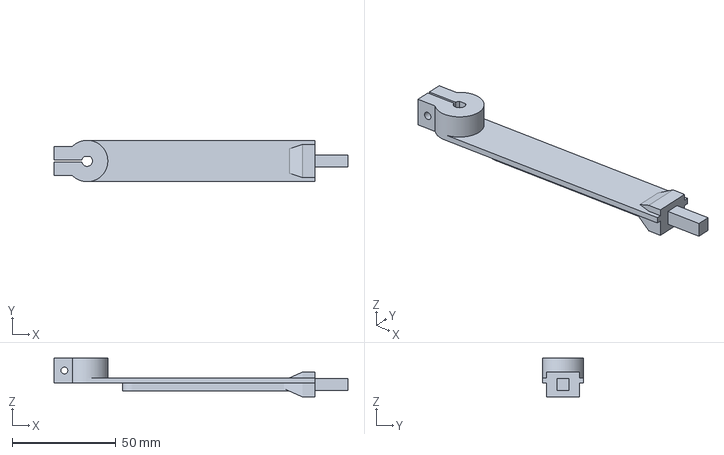
[picture p64: CAD file, 2026-10-10]
exports/split-cart-arms/drive-short-arm-split-1_CONCEPT.3mf
142.0 x 20.0 x 18.8 mm
