Ishfaq-code/magneto/exports/eight-cell/wheel-holder-1-rear_CONCEPT.3mf

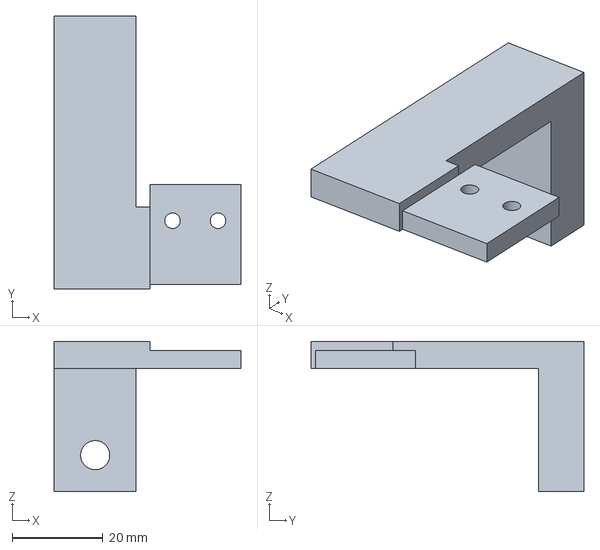
[picture p65: CAD file, 2026-10-10]
exports/eight-cell/wheel-holder-1-rear_CONCEPT.3mf
41.0 x 60.0 x 33.0 mm
