Ishfaq-code/magneto/exports/servo-reset/lower-guide_DRAFT.3mf

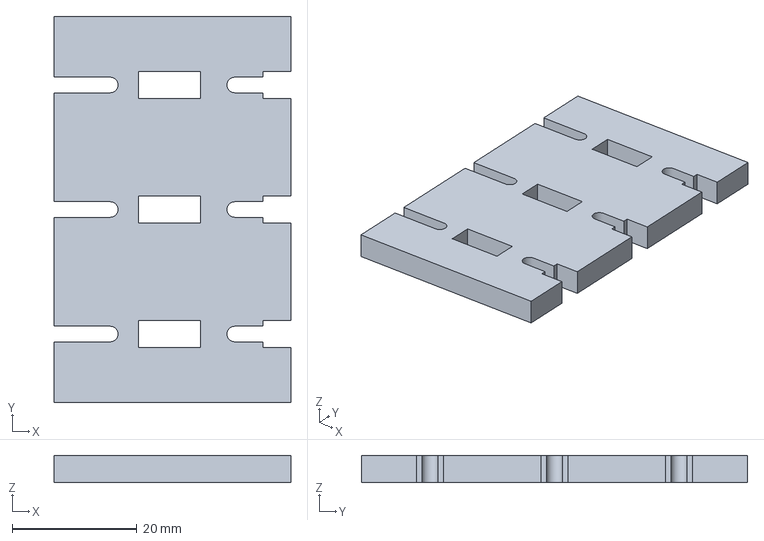
[picture p66: CAD file, 2026-10-10]
exports/servo-reset/lower-guide_DRAFT.3mf
38.0 x 62.0 x 4.40 mm
