Ishfaq-code/magneto/exports/split-cart-arms/drive-long-arm-split-1_CONCEPT.3mf

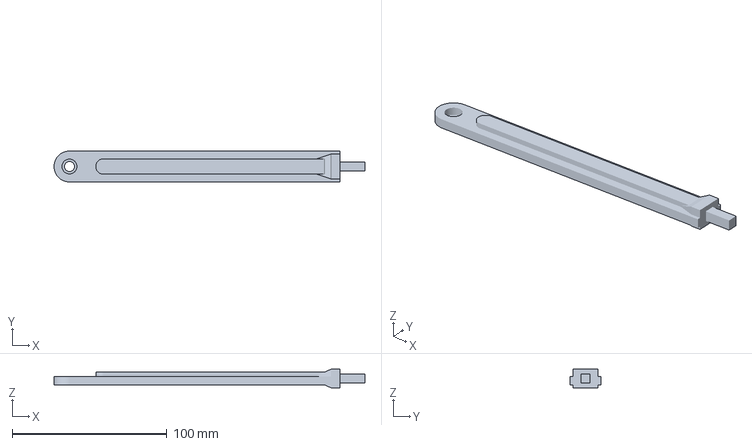
[picture p67: CAD file, 2026-10-10]
exports/split-cart-arms/drive-long-arm-split-1_CONCEPT.3mf
201.0 x 20.0 x 12.0 mm
