Ishfaq-code/magneto/web/models/casing_CONCEPT.3mf

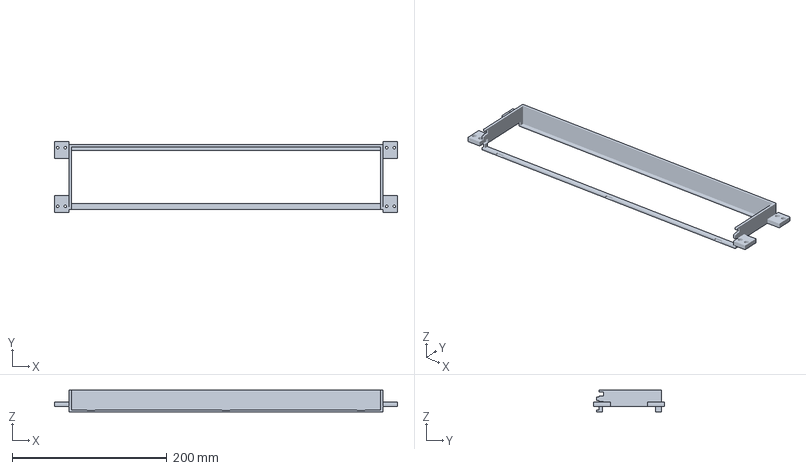
[picture p68: CAD file, 2026-10-10]
web/models/casing_CONCEPT.3mf
444.0 x 92.0 x 28.0 mm
