Ishfaq-code/magneto/exports/split-cart-arms/casing-panel-split-2_CONCEPT.3mf

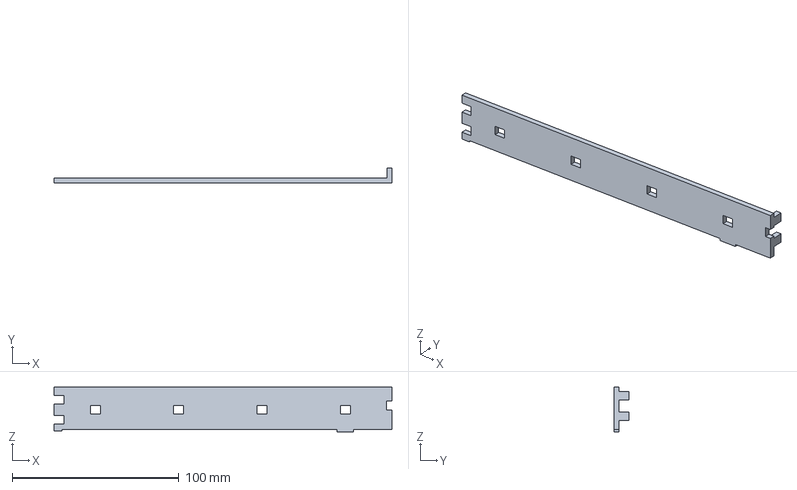
[picture p69: CAD file, 2026-10-10]
exports/split-cart-arms/casing-panel-split-2_CONCEPT.3mf
202.8 x 9.00 x 26.7 mm
