Ishfaq-code/magneto/exports/split-cart-arms/casing-split-2b_CONCEPT.3mf

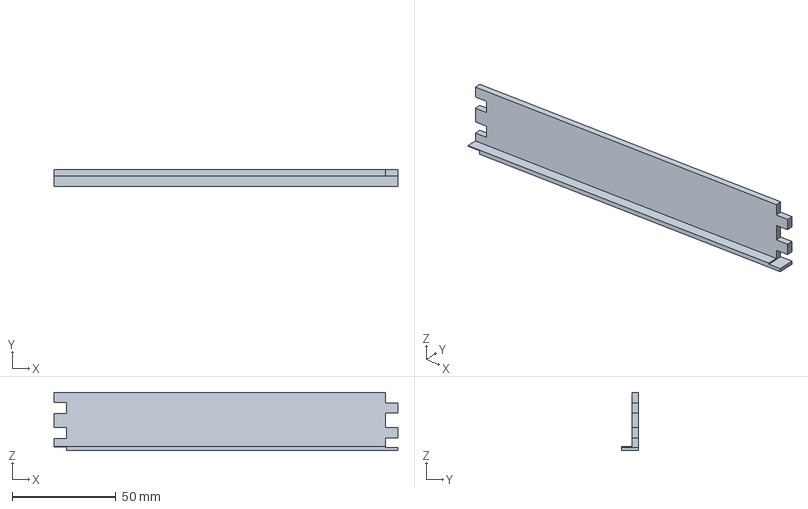
[picture p70: CAD file, 2026-10-10]
exports/split-cart-arms/casing-split-2b_CONCEPT.3mf
165.8 x 8.00 x 28.0 mm
