Ishfaq-code/magneto/web/models/drive-long-arm_CONCEPT.3mf

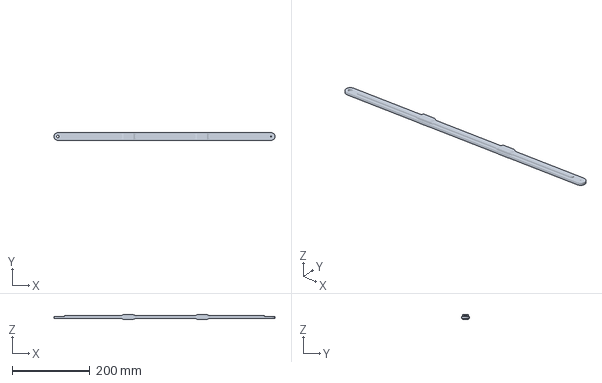
[picture p71: CAD file, 2026-10-10]
web/models/drive-long-arm_CONCEPT.3mf
570.0 x 20.0 x 12.0 mm
