Ishfaq-code/magneto/exports/split-cart-arms/casing-split-3_CONCEPT.3mf

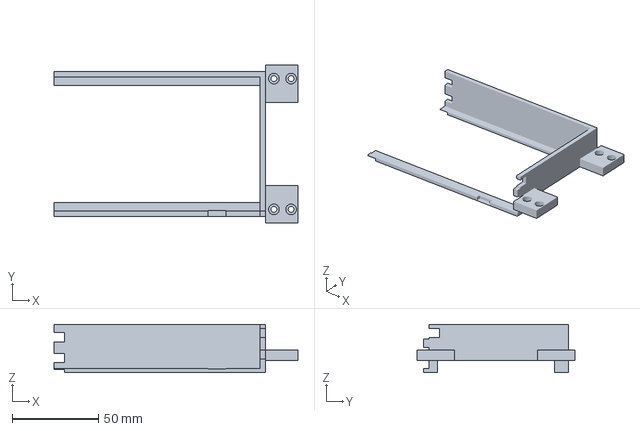
[picture p72: CAD file, 2026-10-10]
exports/split-cart-arms/casing-split-3_CONCEPT.3mf
141.8 x 92.0 x 28.0 mm
