Ishfaq-code/magneto/exports/split-cart-arms/drive-long-arm-split-2_CONCEPT.3mf

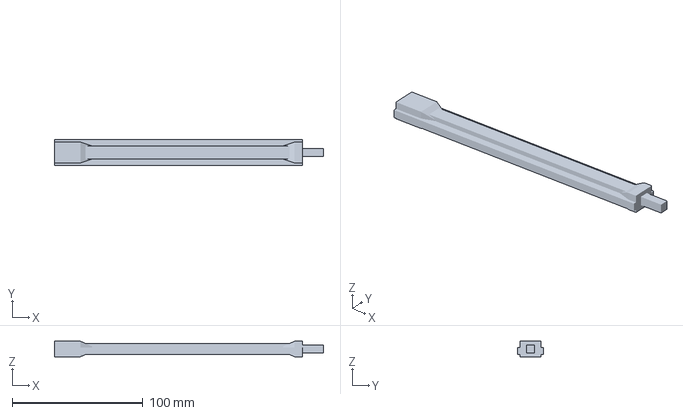
[picture p73: CAD file, 2026-10-10]
exports/split-cart-arms/drive-long-arm-split-2_CONCEPT.3mf
205.8 x 20.0 x 12.0 mm
