Ishfaq-code/magneto/exports/split-cart-arms/drive-short-arm-split-2_CONCEPT.3mf

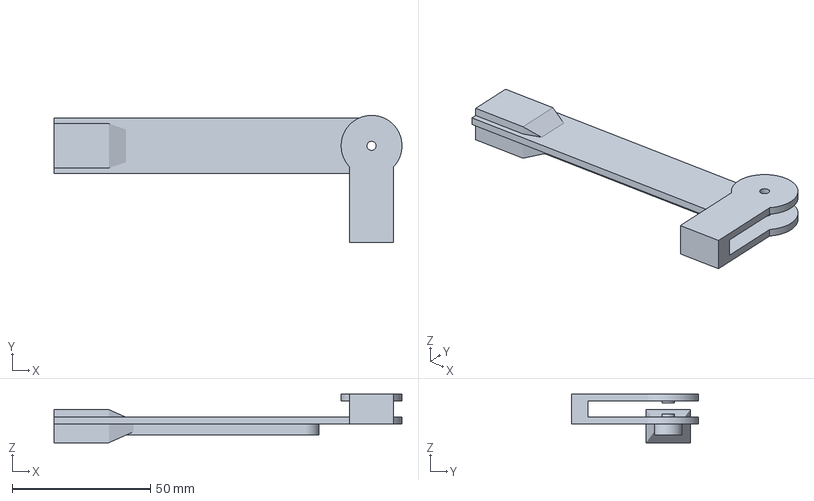
[picture p74: CAD file, 2026-10-10]
exports/split-cart-arms/drive-short-arm-split-2_CONCEPT.3mf
125.8 x 46.0 x 17.6 mm
