Ishfaq-code/magneto/exports/servo-reset/upper-guide_DRAFT.3mf

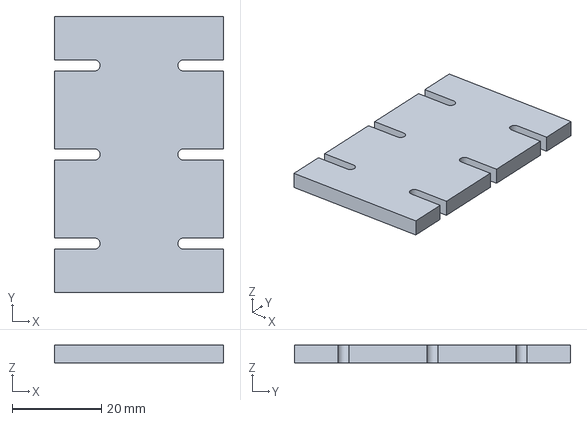
[picture p75: CAD file, 2026-10-10]
exports/servo-reset/upper-guide_DRAFT.3mf
38.0 x 62.0 x 4.00 mm
