Ishfaq-code/magneto/exports/split-cart-arms/drive-long-arm-split-3_CONCEPT.3mf

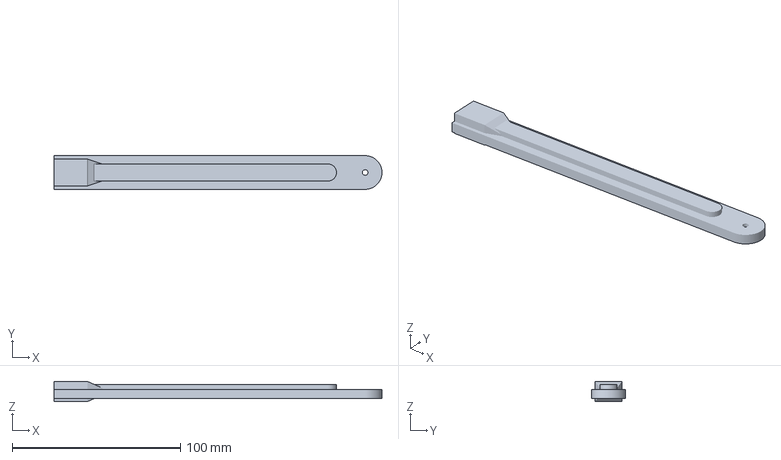
[picture p76: CAD file, 2026-10-10]
exports/split-cart-arms/drive-long-arm-split-3_CONCEPT.3mf
194.8 x 20.0 x 12.0 mm
