Ishfaq-code/magneto/exports/split-cart-arms/casing-panel-split-1_CONCEPT.3mf

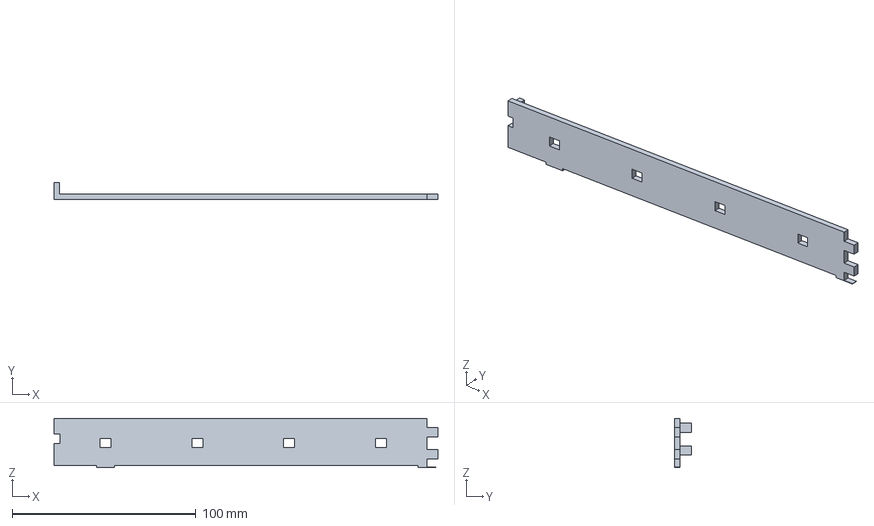
[picture p77: CAD file, 2026-10-10]
exports/split-cart-arms/casing-panel-split-1_CONCEPT.3mf
209.0 x 9.00 x 26.7 mm
