Ishfaq-code/magneto/exports/split-cart-arms/casing-split-2a_CONCEPT.3mf

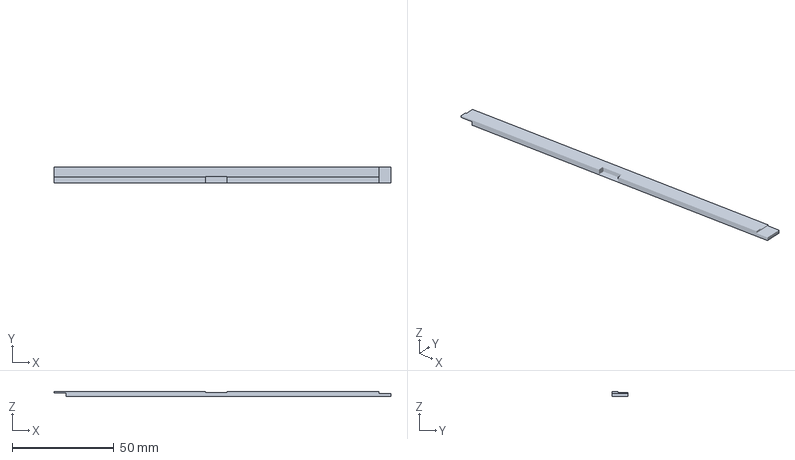
[picture p78: CAD file, 2026-10-10]
exports/split-cart-arms/casing-split-2a_CONCEPT.3mf
165.8 x 8.00 x 2.50 mm
