Ishfaq-code/magneto/(list of files, cad)

Other CAD files:
exports/servo-reset/reading-plate_DRAFT.3mf
exports/resin-stl/bed-A-quantity-plan/cell-base_CONCEPT_qty-04.stl
exports/servo-reset/pin-6_DRAFT.3mf
exports/resin-stl/bed-B-quantity-plan/cell-base_CONCEPT_qty-04.stl
exports/servo-reset/cell-base_DRAFT.3mf
web/models/catch-carrier_CONCEPT.3mf
exports/eight-cell/catch-carrier_CONCEPT.3mf
exports/servo-reset/pin-2_DRAFT.3mf
exports/resin-stl/bed-B-quantity-plan/plunger-keeper-right_CONCEPT_qty-04.stl
exports/servo-reset/reset-carrier_DRAFT.3mf
exports/eight-cell/reset-bracket_CONCEPT.3mf
exports/resin-stl/bed-A-quantity-plan/plunger-keeper-right_CONCEPT_qty-04.stl
exports/servo-reset/pin-3_DRAFT.3mf
web/models/reset-flap_CONCEPT.3mf
exports/cell-base_slotted_extra-0p6mm-headroom_CONCEPT.stl
exports/eight-cell/wheel-holder-1-front_CONCEPT.3mf
exports/servo-reset/pin-5_DRAFT.3mf
web/models/reset-bracket_CONCEPT.3mf
exports/eight-cell/wheel-holder-2-front_CONCEPT.3mf
exports/servo-reset/pin-4_DRAFT.3mf
exports/eight-cell/wheel-holder-2-rear_CONCEPT.3mf
exports/servo-reset/housing_DRAFT.3mf
exports/split-cart-arms/wheel-holder-1-rear_CONCEPT.3mf
web/models/01_flat_carriage_bottom_DRAFT.stl
exports/servo-reset/pin-1_DRAFT.3mf
exports/split-cart-arms/wheel-holder-1-front_CONCEPT.3mf
web/models/03_short_crank_arm_DRAFT.stl
exports/eight-cell/plunger-keeper-left_CONCEPT.3mf
exports/servo-reset/plunger-keeper-right_DRAFT.3mf
web/models/04_motor_shaft_adapter_DRAFT.stl
exports/eight-cell/plunger-keeper-right_CONCEPT.3mf
web/models/02_long_connecting_arm_DRAFT.stl
exports/servo-reset/plunger-keeper-left_DRAFT.3mf
exports/eight-cell/reset-flap_CONCEPT.3mf
exports/split-cart-arms/wheel-holder-2-front_CONCEPT.3mf
exports/eight-cell/reading-plate_CONCEPT.3mf
exports/cell-base_screw-keeper_CONCEPT.stl
exports/drive/01_flat_carriage_bottom_DRAFT.stl
exports/drive/02_long_connecting_arm_DRAFT.stl
exports/drive/03_short_crank_arm_DRAFT.stl
exports/drive/04_motor_shaft_adapter_DRAFT.stl
exports/eight-cell/rail-stand--1-450_CONCEPT.3mf
exports/eight-cell/rail-stand-1--450_CONCEPT.3mf
exports/eight-cell/rail-stand-1-450_CONCEPT.3mf
exports/plunger-keeper-right_screw-keeper_CONCEPT.stl
exports/top-module-bed-256x256.stl
