Ishfaq-code/magneto/exports/extra-guide-clearance-preview.png

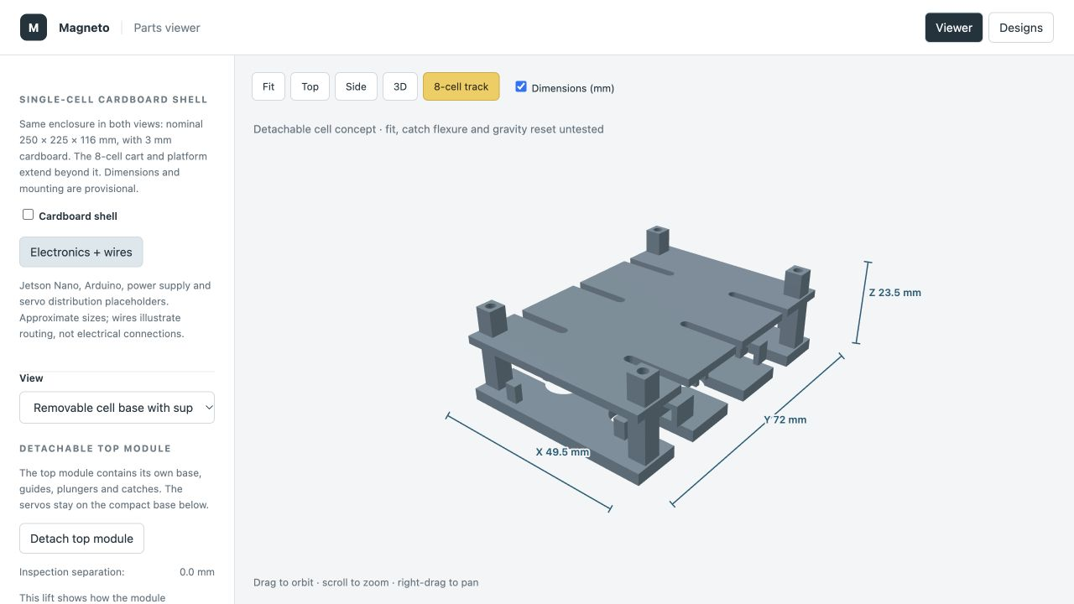
exports/extra-guide-clearance-preview.png
