Ishfaq-code/magneto/exports/servo-reset/slotted-guide-preview.png

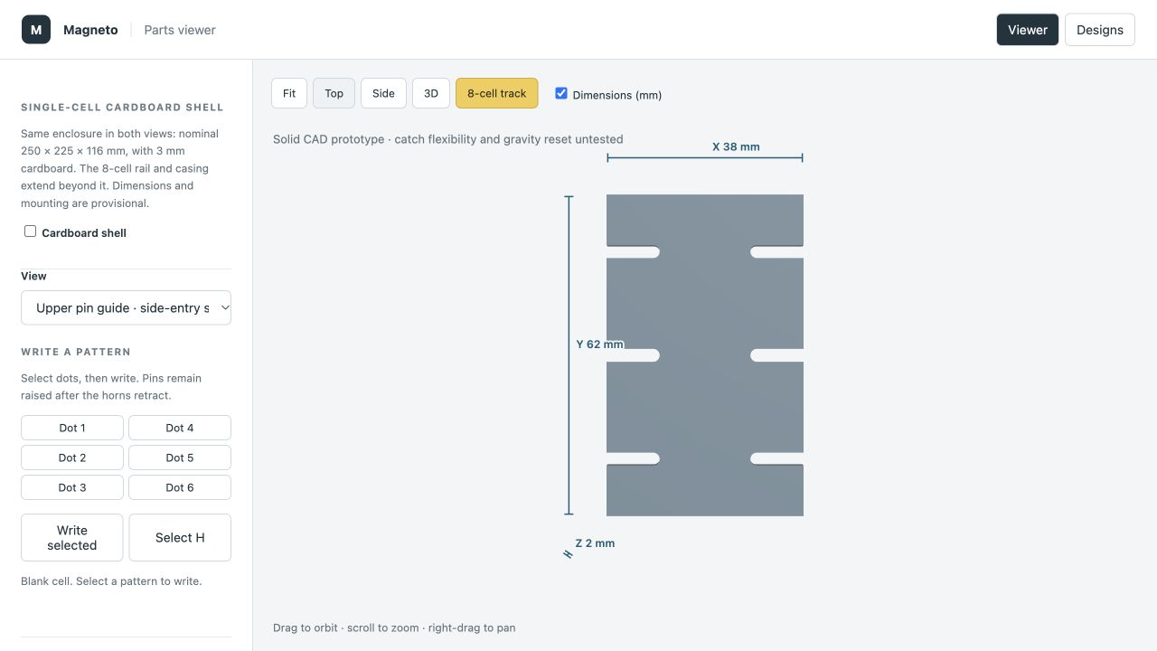
exports/servo-reset/slotted-guide-preview.png
