Ishfaq-code/magneto/(commit log)

2026-10-10 Organize local Magneto viewer and solid CAD with 3MF exports
    [01_flat_carriage_bottom_DRAFT.3mf, 01_flat_carriage_bottom_DRAFT.stl, 02_long_connecting_arm_DRAFT.3mf, 02_long_connecting_arm_DRAFT.stl, 03_short_crank_arm_DRAFT.3mf, 03_short_crank_arm_DRAFT.stl, 04_motor_shaft_adapter.mesh.json, 04_motor_shaft_adapter_DRAFT.3mf]
2026-10-10 Keep Designs open when returning from servo view
2026-10-10 Share viewer header and move yellow track control beside 3D
2026-10-10 Bundle motor-arm design and scope track shortcut to servo reset
2026-10-10 Add responsive Magneto learning companion demo
2026-10-10 Add cane-vision: YOLO object announcer with ElevenLabs voice and Braille spelling
    A camera fixed to the cane identifies the object at the tip with YOLO,
    speaks it (ElevenLabs with cached audio and a local fallback) and spells
    it on the single six-dot cell. Touch is simulated with a key press or
    dwell, and the cell is previewed in the terminal until the servo
    hardware is connected.
    [braille.py, cane.py, cell.py, detector.py, elevenlabs.py, labels.py, pipeline.py]
2026-10-10 Switch cane-vision to YOLO-World with a cane-specific vocabulary
    The detector now finds the names listed in vocabulary.txt (doors, stairs,
    curbs, poles, bollards, trash cans, furniture, vehicles, people) instead
    of COCO's fixed 80 classes. `python -m cane_vision.bake` writes the
    vocabulary into a model and can export it to ONNX or TensorRT so the
    Jetson starts without CLIP. The COCO model remains available via config.
    [bake.py, detector.py, pipeline.py, test_cane.py]
2026-10-10 Add footage review tool and per-class confidence thresholds
    `python -m cane_vision.review` runs the detector over photos and video
    frames, writes annotated images and review.csv, and prints per-class score
    ranges for tuning. `labels.min_confidence` raises the threshold for noisy
    names only.
2026-10-10 Add Arduino firmware for the six-servo Braille cell
    cell-firmware/magneto_cell is an Arduino Uno sketch that drives one SG90 per
    dot on D2-D7. The board holds the Braille table, letter timing and per-servo
    calibrated endpoints (EEPROM), and spells words sent over USB serial
    ("SPELL chair"), clearing between letters and reporting each step back.
    The logic is plain C++ (cell_core) with host tests and a stdin/stdout
    simulator. cane-vision gains SerialCell, which sends words to the board and
    mirrors its reported state in the preview, falling back to the console cell
    when no Arduino is connected. Its tests run the Python driver against the
    simulator through a pty.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
2026-10-10 basic app setup
    [01_flat_carriage_bottom_DRAFT.3mf, 02_long_connecting_arm_DRAFT.3mf, 03_short_crank_arm_DRAFT.3mf, 04_motor_shaft_adapter_DRAFT.3mf, arm-fit-coupon-1_CONCEPT.3mf, arm-fit-coupon-2_CONCEPT.3mf, assembly_CONCEPT.3mf, ball-seat-plunger_CONCEPT_qty-12.stl]
2026-10-10 Add a standalone servo movement test sketch
    cell-firmware/servo_test drives the six dot servos on the same pins as the
    cell firmware (D2-D7 = dots 1-6), with no Braille or calibration: each servo
    swings in turn, then all six together, with Serial Monitor keys to wiggle
    one servo or park them all. It's for checking wiring and the servo supply
    before flashing magneto_cell.
2026-10-11 databricks wiring
2026-10-11 Use the GPU automatically and stop the live feed falling behind
    detector.device now defaults to "auto": CUDA (NVIDIA GPUs and the Jetson,
    with FP16), then Apple's MPS, then CPU. On an Apple Silicon Mac that takes
    YOLO-World from 76 to 18 ms per frame.
    Live cameras are read on a background thread that keeps only the newest
    frame, so a slow detector drops frames instead of queueing them and lagging
    further and further behind. Video files still process every frame.
    The README gains a GPU section: how to check CUDA, installing CUDA PyTorch
    on a PC and on the Jetson (Docker or NVIDIA wheels), and TensorRT.
